kurrosetra/RCWS-FA/MotorControl/Boards/motorControl.brd

## EAGLE design MotorControl/Boards/motorControl.brd (2020-02-27)

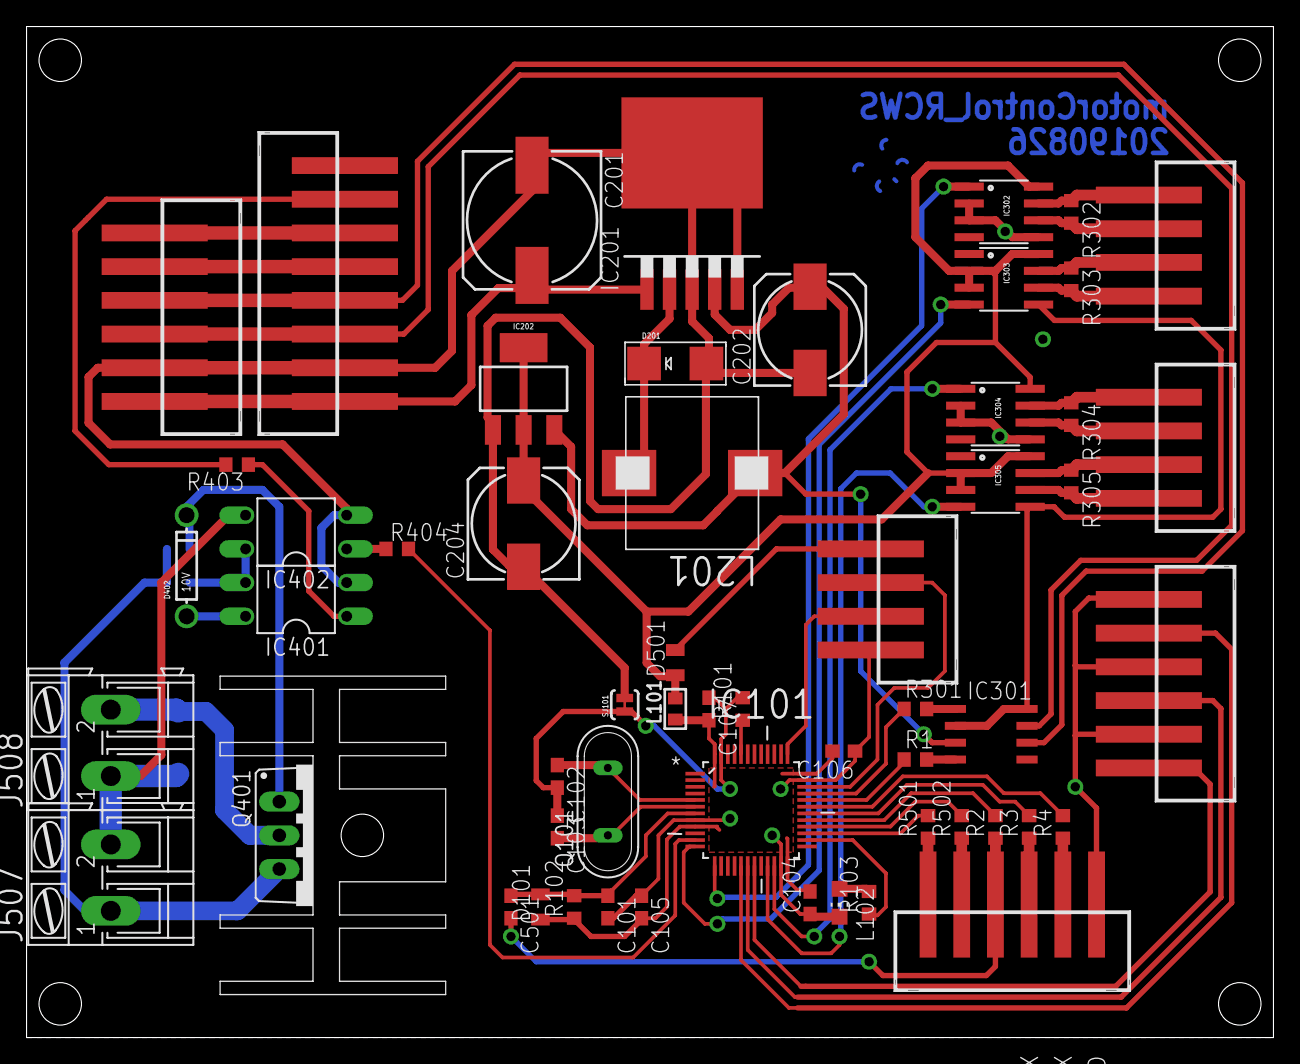
[picture p1: board motorControl.brd from above]

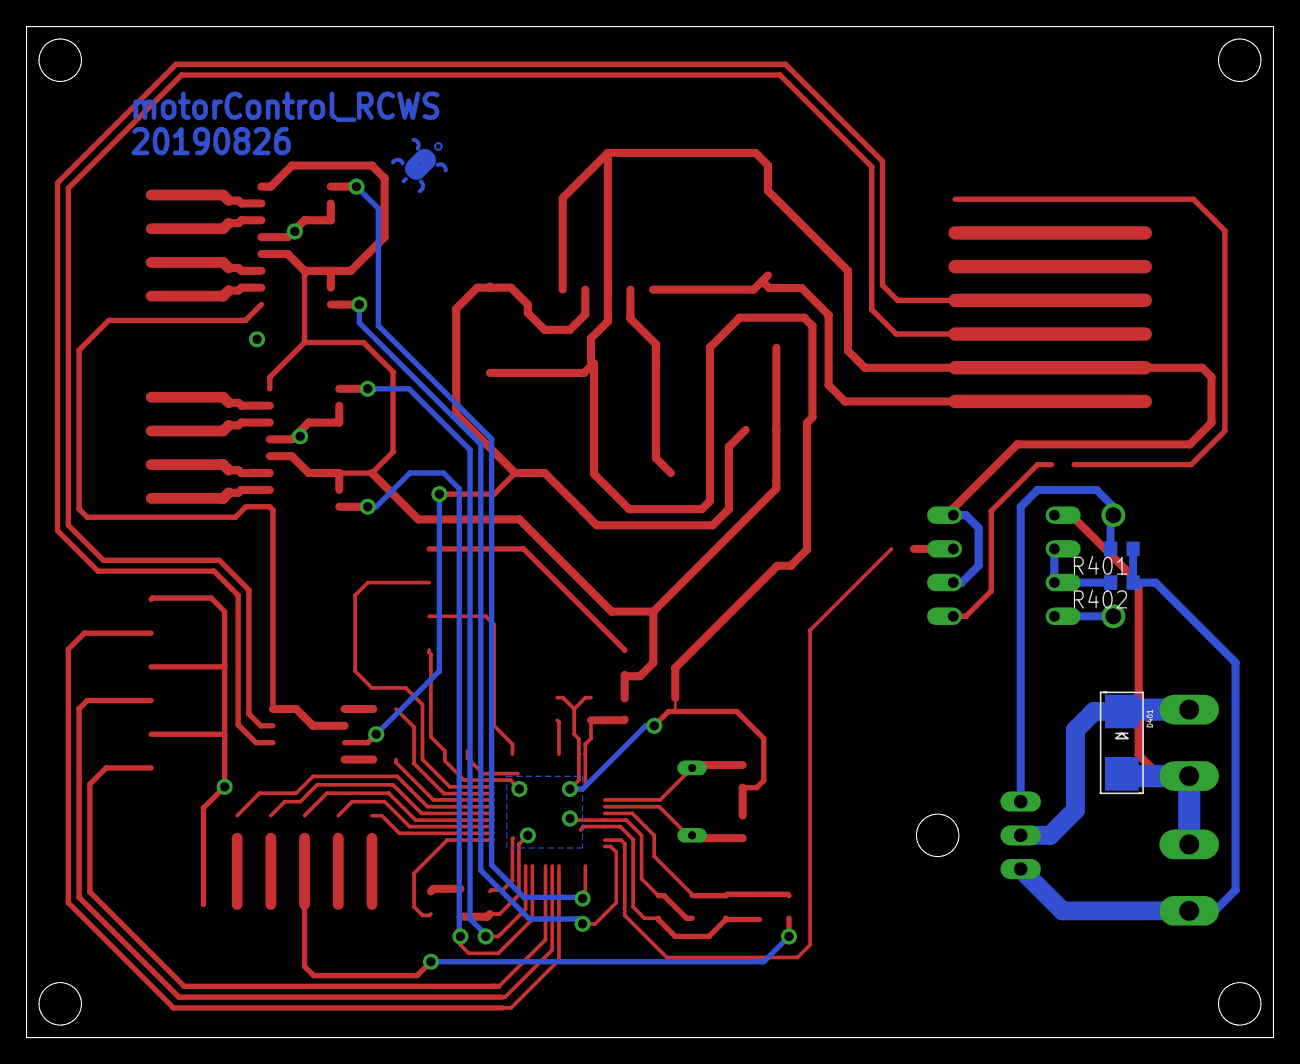
[picture p2: board motorControl.brd from below]

Board: 2 copper layers, 94.0 x 76.2 mm, 61 parts (3 on the bottom side), 59 nets.

Parts:
C101: 10n; C0603
C102, C103: 22p; C0603
C104, C105, C106, C107, C501: 100n; C0603
C201: 470u/35V; 153CLV-1012
C202, C204: 1000u/6V3; 153CLV-0810
D101, D501: SCHOTTKY; MICROMELF-W
D201, D401: SS34; SMADIODE
D402: 10V; DO-4148
IC101: STM32F103C8T6; QFP50P900X900X160-48N
IC201: LM2596S-5V; D2PAK
IC202: LM1117-3V3; SOT223
IC301: MCP2561-E/SN; SOIC-8
IC302, IC303, IC304, IC305: RS485SOIC; SO08
IC401, IC402: PC817; DIL04
J501: PROG; XH-4-VERT-SMD
J502: BUS; XH-8-VERT-SMD
J503: OPTRONIK; XH-6-VERT-SMD
J504: MTR_AZ_COMM; XH-4-VERT-SMD
J505: MTR_EL_COMM; XH-4-VERT-SMD
J506: LIMIT_SWITCH; XH-6-VERT-SMD
J507: POWER_IN; AK300/2
J508: TRIGGER_OUT; AK300/2
J509: COCK_DRIVER; XH-6-VERT-SMD
KK401: BV_240X170-HOLE
L101: FB_0603; L0603
L102: GREEN; CHIP-LED0805
L201: 33uH; PA4342
Q101: 8MHz; QS
Q401: IRF9530; TO220BV
R1, R2, R3, R4, R301, R302, R303, R304, R305, R501, R502: 120R; R0603
R101, R102: 100K; R0603
R103: 1k; R0603
R401: 470R; R0603
R402: 100k; R0603
R403, R404: 330R; R0603
SJ101: SJ_2S-TRACE
U$1: KURRO_FOOTPRINT; KURRO-LOGO

Connections:
+3V3: C204.+, D501.C, IC202.2, IC202.4, IC302.8, IC303.2, IC303.3, IC303.8, IC304.8, IC305.2, IC305.3, IC305.8, L101.2
+5V: C202.+, IC201.4, IC202.3, IC301.3, L201.P$2
+12V: C201.+, IC201.1, J502.1, J503.6
+24V: J507.1, Q401.S, R401.1, R402.1
AGND: C101.2, C102.2, C103.1, C104.1, C105.1, C106.1, C107.1, IC101.8, IC101.23, IC101.35, IC101.47, J501.4, L102.C, R101.2, SJ101.1
BOOT0: IC101.44, R101.1
BUS_CANH: IC301.7, J502.3, J503.4
BUS_CANL: IC301.6, J502.4, J503.3
BUS_RXD: IC101.32, R1.1
BUS_TRIGGER_PULSE: J502.7, R403.2
BUS_TXD: IC101.33, R301.1
BUS_VIDEO+: J502.5, J503.2
BUS_VIDEO-: J502.6, J503.1
COCK_ALM: IC101.31, R4.2
COCK_AWO: IC101.28, R502.2
COCK_DIR: IC101.29, R2.2
COCK_PLS: IC101.30, R3.2
COCK_POS: IC101.27, R501.2
GND: C201.-, C202.-, C204.-, D201.A, IC201.3, IC201.5, IC201.6, IC202.1, IC301.2, IC301.8, IC302.2, IC302.3, IC302.5, IC303.5, IC304.2, IC304.3, IC304.5, IC305.5, IC401.2, IC402.2, J502.2, J503.5, J506.1, J506.3, J506.5, J509.1, SJ101.2
LIM_AZ: IC101.17, J506.2
LIM_EL_DOWN: IC101.19, J506.6
LIM_EL_UP: IC101.18, J506.4
LM2596_OUT: D201.C, IC201.2, L201.P$1
MTR_AZ_RXD: IC101.13, IC302.1
MTR_AZ_RX_A: IC303.6, J504.4, R303.2
MTR_AZ_RX_B: IC303.7, J504.3, R303.1
MTR_AZ_TXD: IC101.12, IC303.4
MTR_AZ_TX_A: IC302.6, J504.2, R302.2
MTR_AZ_TX_B: IC302.7, J504.1, R302.1
MTR_EL_RXD: IC101.22, IC304.1
MTR_EL_RX_A: IC305.6, J505.4, R305.2
MTR_EL_RX_B: IC305.7, J505.3, R305.1
MTR_EL_TXD: IC101.21, IC305.4
MTR_EL_TX_A: IC304.6, J505.2, R304.2
MTR_EL_TX_B: IC304.7, J505.1, R304.1
unnamed: L102.A, R103.2
unnamed: IC101.26, R103.1
unnamed: C103.2, IC101.6, Q101.1
unnamed: C102.1, IC101.5, Q101.2
unnamed: IC301.1, R301.2
unnamed: IC301.4, R1.2
unnamed: J509.5, R502.1
unnamed: J509.6, R501.1
unnamed: C501.2, J509.4, R2.1
unnamed: J509.3, R3.1
unnamed: J509.2, R4.1
unnamed: D501.A, J501.1
unnamed: D402.C, Q401.G, R401.2
unnamed: IC401.3, IC402.4, R402.2
unnamed: IC401.1, R403.1
unnamed: IC402.1, R404.1
unnamed: D402.A, IC401.4
RST: C101.1, C501.1, D101.A, IC101.7, R102.2
SWCLK: IC101.37, J501.3
SWDIO: IC101.34, J501.2
TRIGGER+: D401.C, J508.2, Q401.D
TRIGGER_ENABLE: IC101.11, R404.2
V-: D401.A, IC402.3, J507.2, J508.1
VDD: C104.2, C105.2, C106.2, C107.2, D101.C, IC101.9, IC101.24, IC101.36, IC101.48, L101.1, R102.1
