kurrosetra/RCWS-FA/Button/Boards/Button.brd

## EAGLE design Button/Boards/Button.brd (2020-02-27)

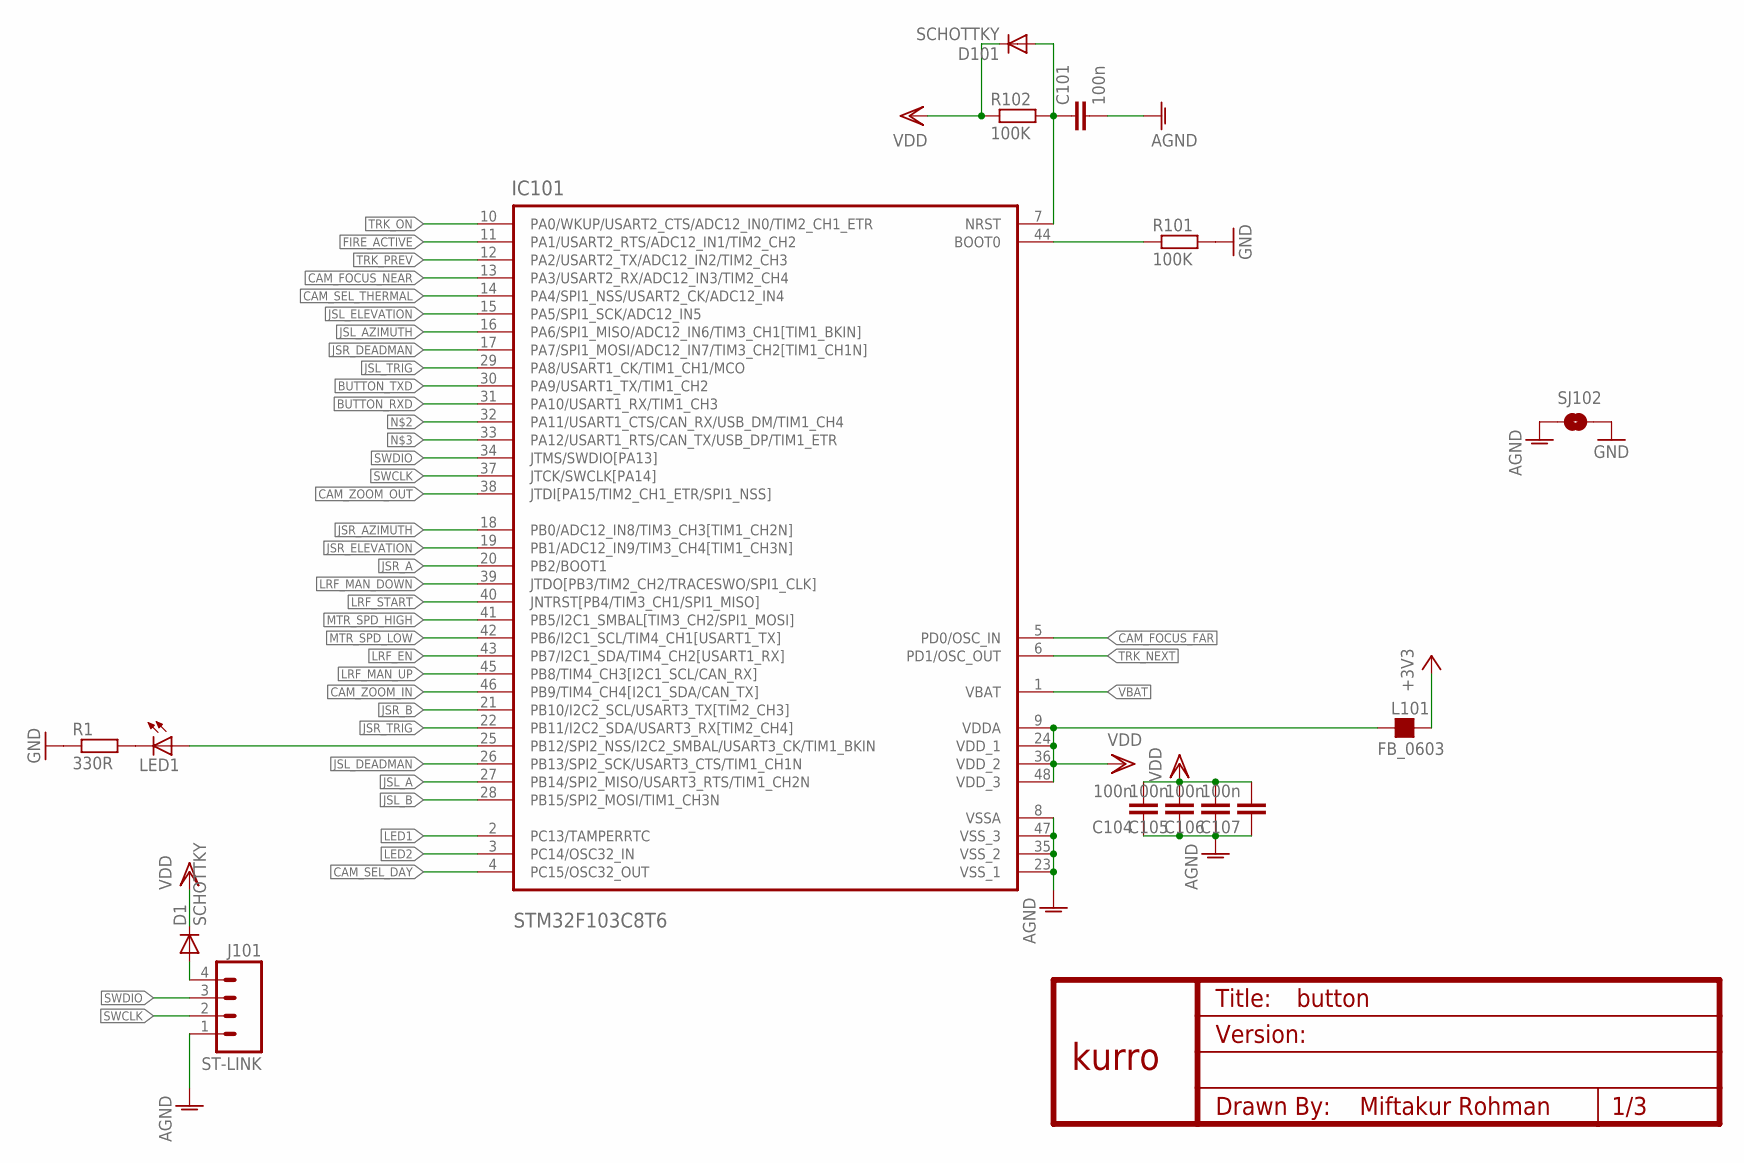
[picture p3: schematic Button.sch, sheet 1, CONTROLLER]

Parts:
C101, C104, C105, C106, C107: 100n; C0603
D1, D101: SCHOTTKY; MICROMELF-W
IC101: STM32F103C8T6; QFP50P900X900X160-48N
J101: ST-LINK; XH-4-VERT
L101: FB_0603; L0603
LED1: LED-3MM-NO_SILK; LED3MM-NS
R1: 330R; R0603
R101, R102: 100K; R0603
SJ102: SOLDERJUMPERTRACE; SJ_2S-TRACE
U$1: KURRO_FOOTPRINT; KURRO-LOGO

Connections:
+3V3: L101.2; also elsewhere on the board
AGND: C101.2, C104.1, C105.1, C106.1, C107.1, IC101.8 (VSSA), IC101.23 (VSS_1), IC101.35 (VSS_2), IC101.47 (VSS_3), J101.1, SJ102.1
BOOT0: IC101.44 (BOOT0), R101.1
BUTTON_RXD: IC101.31 (PA10/USART1_RX/TIM1_CH3); also elsewhere on the board
BUTTON_TXD: IC101.30 (PA9/USART1_TX/TIM1_CH2); also elsewhere on the board
CAM_FOCUS_FAR: IC101.5 (PD0/OSC_IN); also elsewhere on the board
CAM_FOCUS_NEAR: IC101.13 (PA3/USART2_RX/ADC12_IN3/TIM2_CH4); also elsewhere on the board
CAM_SEL_DAY: IC101.4 (PC15/OSC32_OUT); also elsewhere on the board
CAM_SEL_THERMAL: IC101.14 (PA4/SPI1_NSS/USART2_CK/ADC12_IN4); also elsewhere on the board
CAM_ZOOM_IN: IC101.46 (PB9/TIM4_CH4[I2C1_SDA/CAN_TX]); also elsewhere on the board
CAM_ZOOM_OUT: IC101.38 (JTDI[PA15/TIM2_CH1_ETR/SPI1_NSS]); also elsewhere on the board
FIRE_ACTIVE: IC101.11 (PA1/USART2_RTS/ADC12_IN1/TIM2_CH2); also elsewhere on the board
GND: R1.1, R101.2, SJ102.2; also elsewhere on the board
JSL_A: IC101.27 (PB14/SPI2_MISO/USART3_RTS/TIM1_CH2N); also elsewhere on the board
JSL_AZIMUTH: IC101.16 (PA6/SPI1_MISO/ADC12_IN6/TIM3_CH1[TIM1_B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); also elsewhere on the board
JSL_B: IC101.28 (PB15/SPI2_MOSI/TIM1_CH3N); also elsewhere on the board
JSL_DEADMAN: IC101.26 (PB13/SPI2_SCK/USART3_CTS/TIM1_CH1N); also elsewhere on the board
JSL_ELEVATION: IC101.15 (PA5/SPI1_SCK/ADC12_IN5); also elsewhere on the board
JSL_TRIG: IC101.29 (PA8/USART1_CK/TIM1_CH1/MCO); also elsewhere on the board
JSR_A: IC101.20 (PB2/BOOT1); also elsewhere on the board
JSR_AZIMUTH: IC101.18 (PB0/ADC12_IN8/TIM3_CH3[TIM1_CH2N]); also elsewhere on the board
JSR_B: IC101.21 (PB10/I2C2_SCL/USART3_TX[TIM2_CH3]); also elsewhere on the board
JSR_DEADMAN: IC101.17 (PA7/SPI1_MOSI/ADC12_IN7/TIM3_CH2[TIM1_C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); also elsewhere on the board
JSR_ELEVATION: IC101.19 (PB1/ADC12_IN9/TIM3_CH4[TIM1_CH3N]); also elsewhere on the board
JSR_TRIG: IC101.22 (PB11/I2C2_SDA/USART3_RX[TIM2_CH4]); also elsewhere on the board
LED1: IC101.2 (PC13/TAMPERRTC); also elsewhere on the board
LED2: IC101.3 (PC14/OSC32_IN); also elsewhere on the board
LRF_EN: IC101.43 (PB7/I2C1_SDA/TIM4_CH2[USART1_RX]); also elsewhere on the board
LRF_MAN_DOWN: IC101.39 (JTDO[PB3/TIM2_CH2/TRACESWO/SPI1_CLK]); also elsewhere on the board
LRF_MAN_UP: IC101.45 (PB8/TIM4_CH3[I2C1_SCL/CAN_RX]); also elsewhere on the board
LRF_START: IC101.40 (JNTRST[PB4/TIM3_CH1/SPI1_MISO]); also elsewhere on the board
MTR_SPD_HIGH: IC101.41 (PB5/I2C1_SMBAL[TIM3_CH2/SPI1_MOSI]); also elsewhere on the board
MTR_SPD_LOW: IC101.42 (PB6/I2C1_SCL/TIM4_CH1[USART1_TX]); also elsewhere on the board
unnamed: IC101.25 (PB12/SPI2_NSS/I2C2_SMBAL/USART3_CK/TIM1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), LED1.A
unnamed: D1.A, J101.4
unnamed: LED1.K (C), R1.2
RST: C101.1, D101.A, IC101.7 (NRST), R102.2
SWCLK: IC101.37 (JTCK/SWCLK[PA14]), J101.2
SWDIO: IC101.34 (JTMS/SWDIO[PA13]), J101.3
TRK_NEXT: IC101.6 (PD1/OSC_OUT); also elsewhere on the board
TRK_ON: IC101.10 (PA0/WKUP/USART2_CTS/ADC12_IN0/TIM2_CH1_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); also elsewhere on the board
TRK_PREV: IC101.12 (PA2/USART2_TX/ADC12_IN2/TIM2_CH3); also elsewhere on the board
VBAT: IC101.1 (VBAT)
VDD: C104.2, C105.2, C106.2, C107.2, D1.C, D101.C, IC101.9 (VDDA), IC101.24 (VDD_1), IC101.36 (VDD_2), IC101.48 (VDD_3), L101.1, R102.1

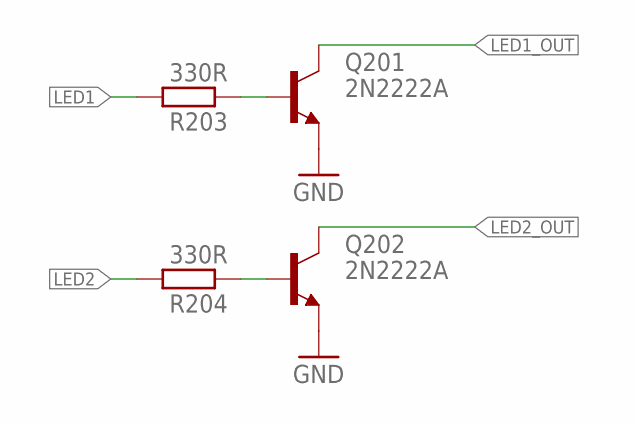
[picture p4: schematic Button.sch, sheet 2]

Parts:
Q201, Q202: 2N2222A; SOT23
R203, R204: 330R; R0603

Connections:
GND: Q201.2 (E), Q202.2 (E); also elsewhere on the board
LED1: R203.2; also elsewhere on the board
LED1_OUT: Q201.3 (C); also elsewhere on the board
LED2: R204.2; also elsewhere on the board
LED2_OUT: Q202.3 (C); also elsewhere on the board
unnamed: Q201.1 (B), R203.1
unnamed: Q202.1 (B), R204.1

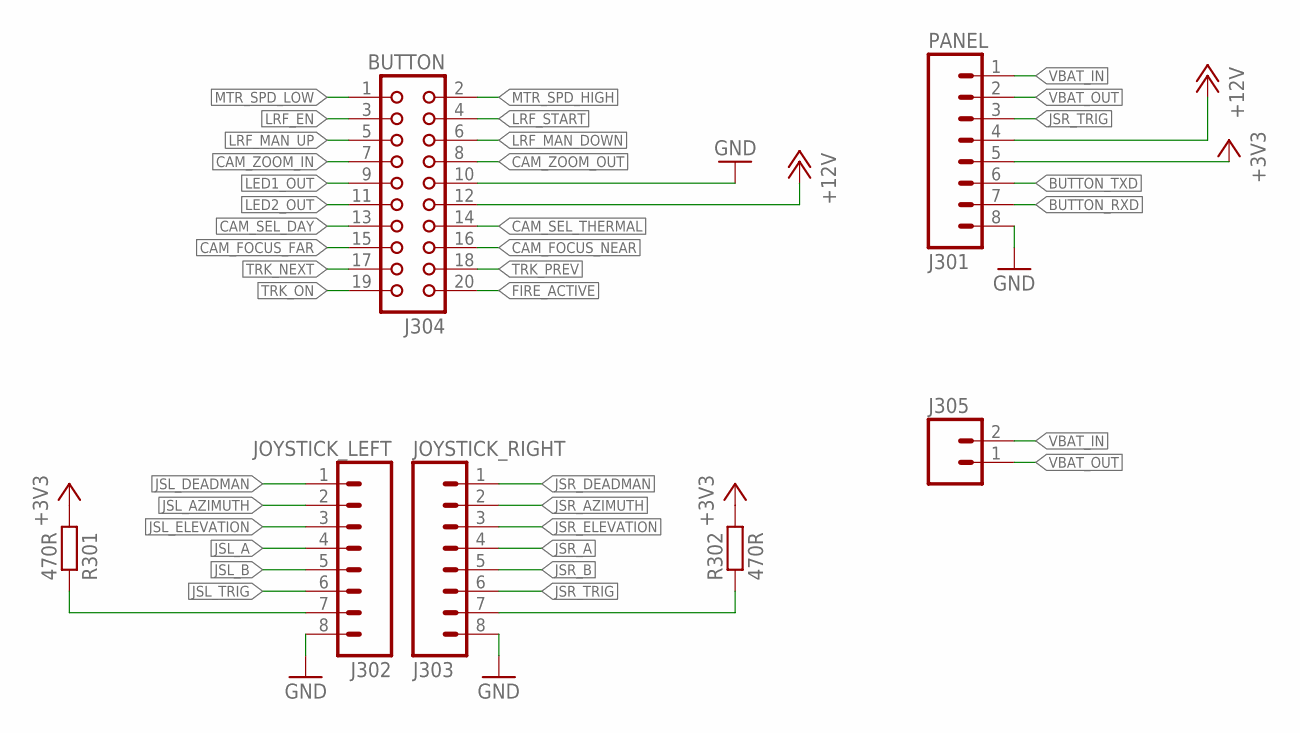
[picture p5: schematic Button.sch, sheet 3, CONNECTOR]

Parts:
J301: PANEL; XH-8-RA
J302: JOYSTICK_LEFT; XH-8-RA
J303: JOYSTICK_RIGHT; XH-8-RA
J304: BUTTON; CON20
J305: M02-XH-RA; XH-2-RA
R301, R302: 470R; R0603

Connections:
+3V3: J301.5, R301.2, R302.2; also elsewhere on the board
+12V: J301.4, J304.12
BUTTON_RXD: J301.7; also elsewhere on the board
BUTTON_TXD: J301.6; also elsewhere on the board
CAM_FOCUS_FAR: J304.15; also elsewhere on the board
CAM_FOCUS_NEAR: J304.16; also elsewhere on the board
CAM_SEL_DAY: J304.13; also elsewhere on the board
CAM_SEL_THERMAL: J304.14; also elsewhere on the board
CAM_ZOOM_IN: J304.7; also elsewhere on the board
CAM_ZOOM_OUT: J304.8; also elsewhere on the board
FIRE_ACTIVE: J304.20; also elsewhere on the board
GND: J301.8, J302.8, J303.8, J304.10; also elsewhere on the board
JSL_A: J302.4; also elsewhere on the board
JSL_AZIMUTH: J302.2; also elsewhere on the board
JSL_B: J302.5; also elsewhere on the board
JSL_DEADMAN: J302.1; also elsewhere on the board
JSL_ELEVATION: J302.3; also elsewhere on the board
JSL_TRIG: J302.6; also elsewhere on the board
JSR_A: J303.4; also elsewhere on the board
JSR_AZIMUTH: J303.2; also elsewhere on the board
JSR_B: J303.5; also elsewhere on the board
JSR_DEADMAN: J303.1; also elsewhere on the board
JSR_ELEVATION: J303.3; also elsewhere on the board
JSR_TRIG: J301.3, J303.6; also elsewhere on the board
LED1_OUT: J304.9; also elsewhere on the board
LED2_OUT: J304.11; also elsewhere on the board
LRF_EN: J304.3; also elsewhere on the board
LRF_MAN_DOWN: J304.6; also elsewhere on the board
LRF_MAN_UP: J304.5; also elsewhere on the board
LRF_START: J304.4; also elsewhere on the board
MTR_SPD_HIGH: J304.2; also elsewhere on the board
MTR_SPD_LOW: J304.1; also elsewhere on the board
unnamed: J303.7, R302.1
unnamed: J302.7, R301.1
TRK_NEXT: J304.17; also elsewhere on the board
TRK_ON: J304.19; also elsewhere on the board
TRK_PREV: J304.18; also elsewhere on the board
VBAT_IN: J301.1, J305.2
VBAT_OUT: J301.2, J305.1

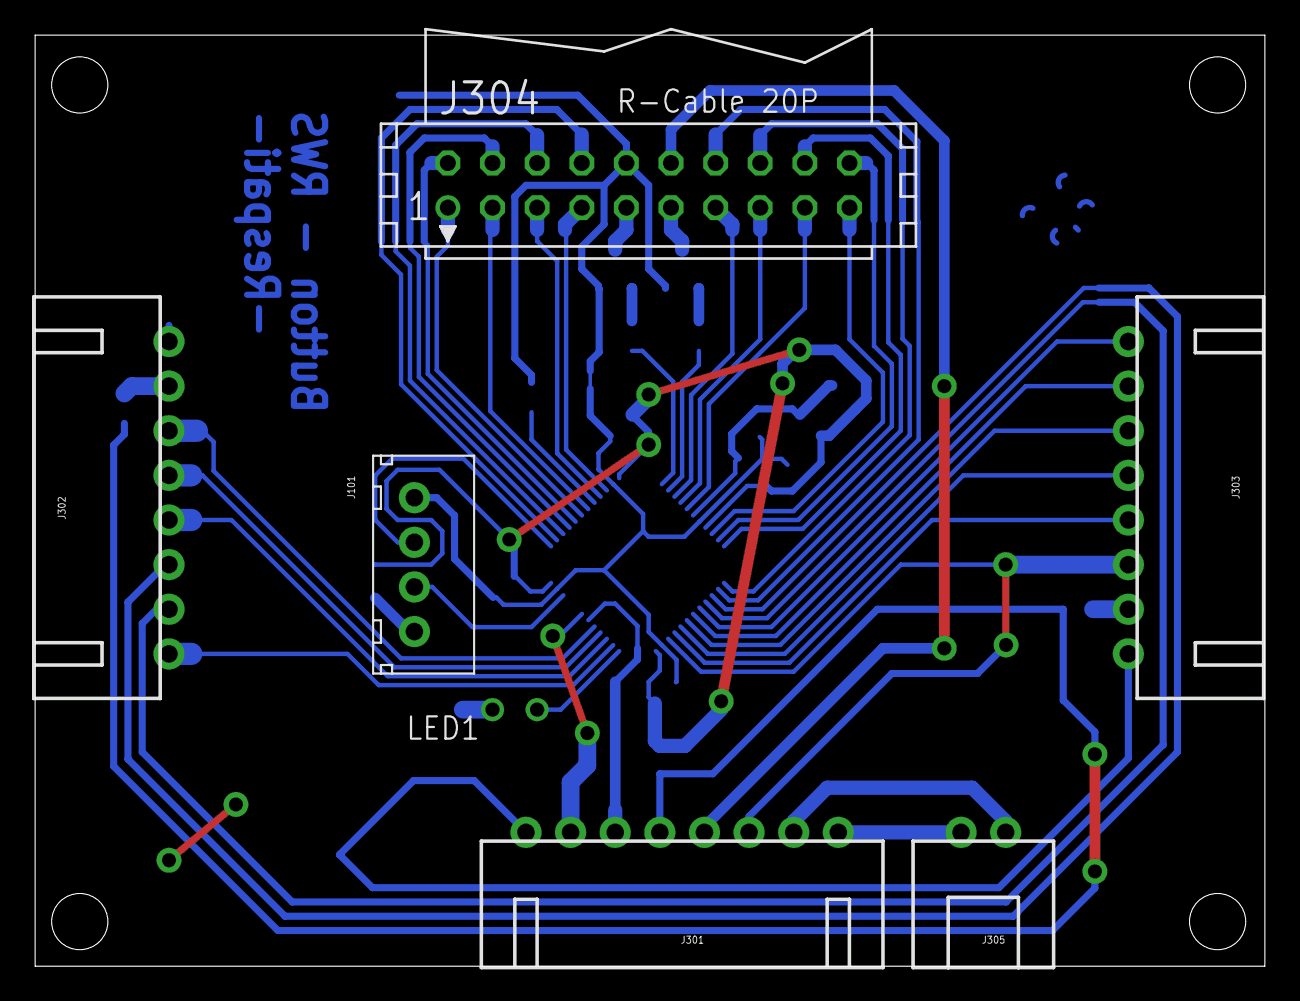
[picture p6: board Button.brd from above]

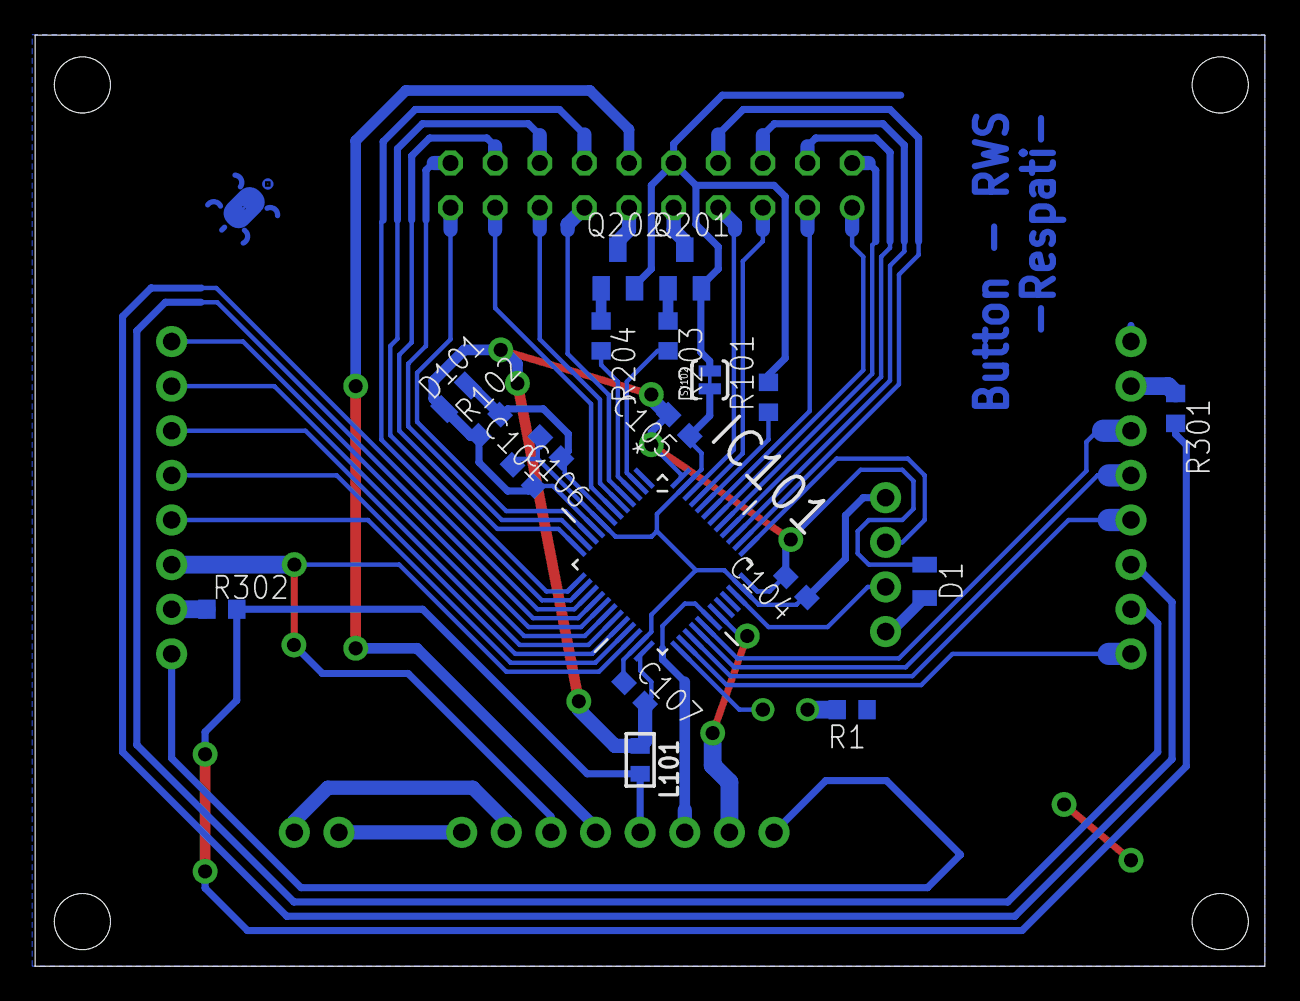
[picture p7: board Button.brd from below]

Board: 2 copper layers, 70.0 x 53.0 mm, 27 parts (19 on the bottom side), 52 nets.
