kurrosetra/RCWS-FA/Panel/Boards/panel446.brd

## EAGLE design Panel/Boards/panel446.brd (2020-02-27)

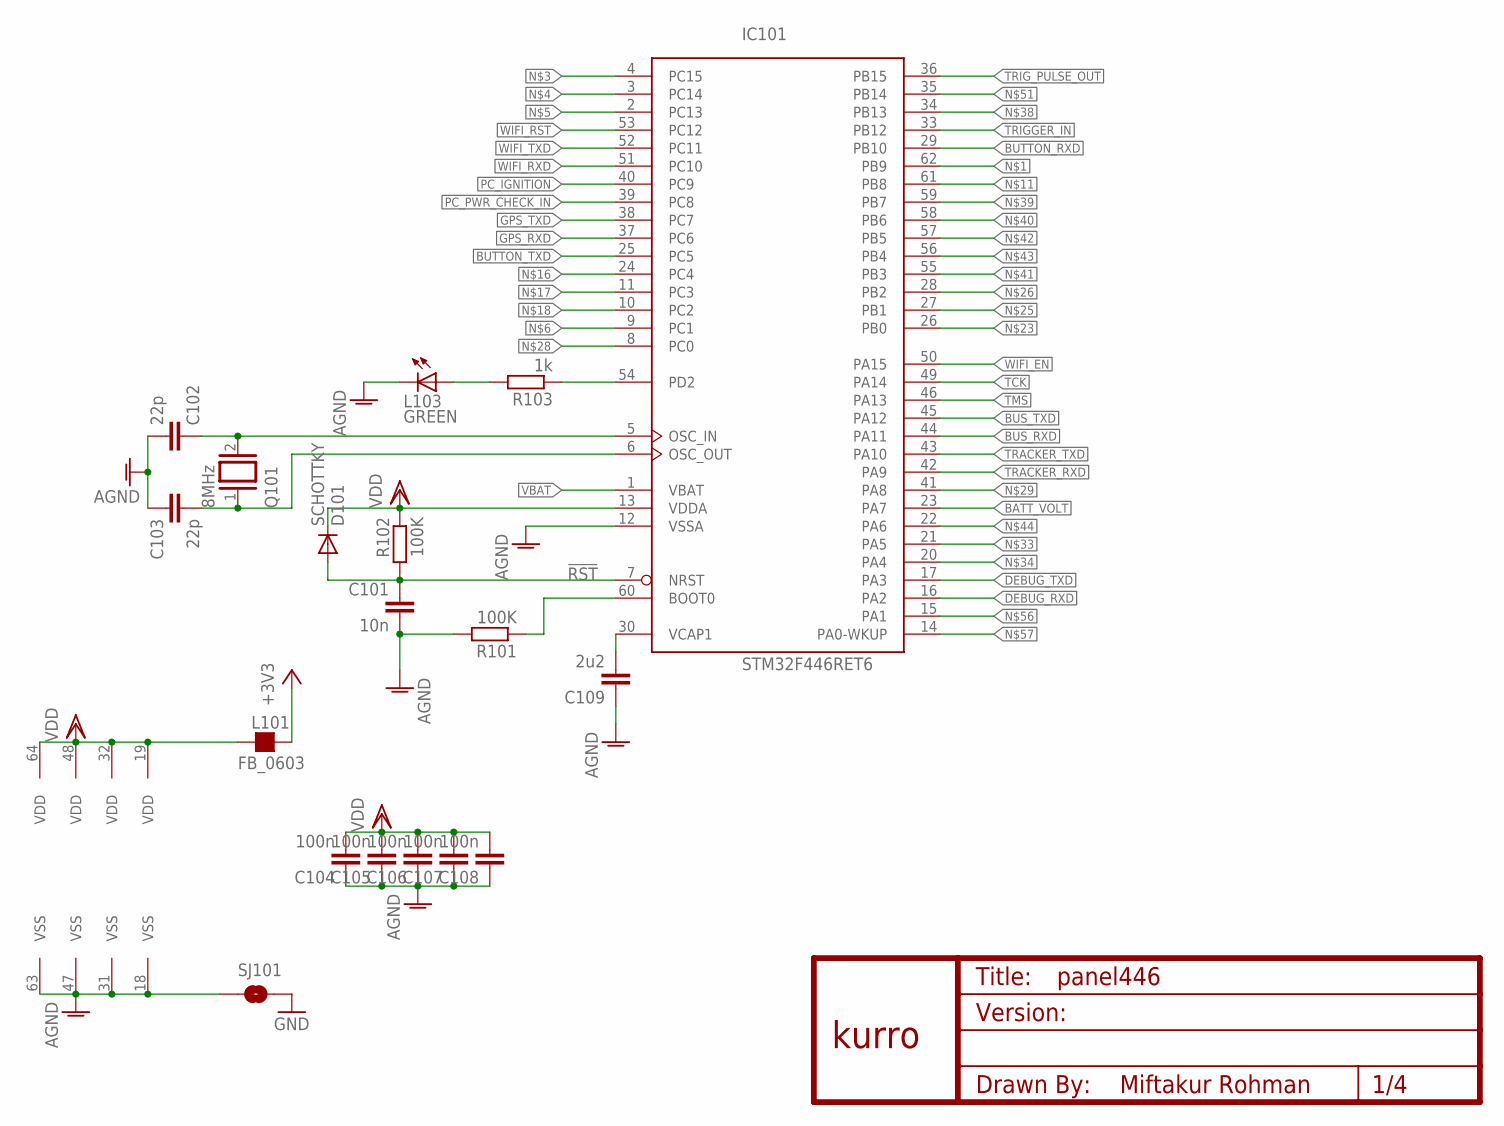
[picture p8: schematic panel446.sch, sheet 1, MAIN]

Parts:
C101: 10n; C0603
C102, C103: 22p; C0603
C104, C105, C106, C107, C108: 100n; C0603
C109: 2u2; C0805
D101: SCHOTTKY; MICROMELF-W
IC101: STM32F446RET6; LQFP64
L101: FB_0603; L0603
L103: GREEN; CHIP-LED0805
Q101: 8MHz; QS
R101, R102: 100K; R0603
R103: 1k; R0603
SJ101: SOLDERJUMPERTRACE; SJ_2S-TRACE
U$1: KURRO_FOOTPRINT; KURRO-LOGO

Connections:
!RST: C101.1, D101.A, IC101.7 (NRST), R102.2; also elsewhere on the board
+3V3: L101.2; also elsewhere on the board
AGND: C101.2, C102.2, C103.1, C104.1, C105.1, C106.1, C107.1, C108.1, C109.1, IC101.12 (VSSA), IC101.18 (VSS), IC101.31 (VSS), IC101.47 (VSS), IC101.63 (VSS), L103.C, R101.2, SJ101.1; also elsewhere on the board
BATT_VOLT: IC101.23 (PA7); also elsewhere on the board
BOOT1: IC101.60 (BOOT0), R101.1
BUS_RXD: IC101.44 (PA11); also elsewhere on the board
BUS_TXD: IC101.45 (PA12); also elsewhere on the board
BUTTON_RXD: IC101.29 (PB10); also elsewhere on the board
BUTTON_TXD: IC101.25 (PC5); also elsewhere on the board
DEBUG_RXD: IC101.16 (PA2); also elsewhere on the board
DEBUG_TXD: IC101.17 (PA3); also elsewhere on the board
GND: SJ101.2; also elsewhere on the board
GPS_RXD: IC101.37 (PC6); also elsewhere on the board
GPS_TXD: IC101.38 (PC7); also elsewhere on the board
unnamed: C109.2, IC101.30 (VCAP1)
unnamed: IC101.54 (PD2), R103.1
unnamed: L103.A, R103.2
unnamed: C103.2, IC101.6 (OSC_OUT), Q101.1
unnamed: C102.1, IC101.5 (OSC_IN), Q101.2
PC_IGNITION: IC101.40 (PC9); also elsewhere on the board
PC_PWR_CHECK_IN: IC101.39 (PC8); also elsewhere on the board
TCK: IC101.49 (PA14); also elsewhere on the board
TMS: IC101.46 (PA13); also elsewhere on the board
TRACKER_RXD: IC101.42 (PA9); also elsewhere on the board
TRACKER_TXD: IC101.43 (PA10); also elsewhere on the board
TRIGGER_IN: IC101.33 (PB12); also elsewhere on the board
TRIG_PULSE_OUT: IC101.36 (PB15); also elsewhere on the board
VBAT: IC101.1 (VBAT)
VDD: C104.2, C105.2, C106.2, C107.2, C108.2, D101.C, IC101.13 (VDDA), IC101.19 (VDD), IC101.32 (VDD), IC101.48 (VDD), IC101.64 (VDD), L101.1, R102.1; also elsewhere on the board
WIFI_EN: IC101.50 (PA15); also elsewhere on the board
WIFI_RST: IC101.53 (PC12); also elsewhere on the board
WIFI_RXD: IC101.51 (PC10); also elsewhere on the board
WIFI_TXD: IC101.52 (PC11); also elsewhere on the board

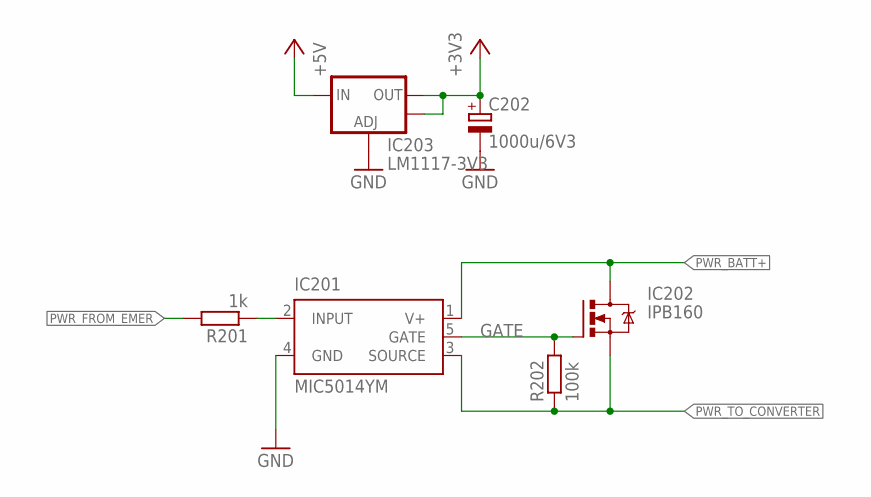
[picture p9: schematic panel446.sch, sheet 2]

Parts:
C202: 1000u/6V3; 153CLV-0810
IC201: MIC5014YM; SO-08
IC202: IPB160; PG-TO263-7
IC203: LM1117-3V3; SOT223
R201: 1k; R0603
R202: 100k; R0603

Connections:
+3V3: C202.+, IC203.2 (OUT), IC203.4 (OUT); also elsewhere on the board
+5V: IC203.3 (IN); also elsewhere on the board
GATE: IC201.5 (GATE), IC202.1 (G), R202.2
GND: C202.-, IC201.4 (GND), IC203.1 (ADJ); also elsewhere on the board
unnamed: IC201.2 (INPUT), R201.1
PWR_BATT+: IC201.1 (V+), IC202.4 (D); also elsewhere on the board
PWR_FROM_EMER: R201.2; also elsewhere on the board
PWR_TO_CONVERTER: IC201.3 (SOURCE), IC202.2 (S), IC202.3 (S), IC202.5 (S), IC202.6 (S), IC202.7 (S), R202.1; also elsewhere on the board

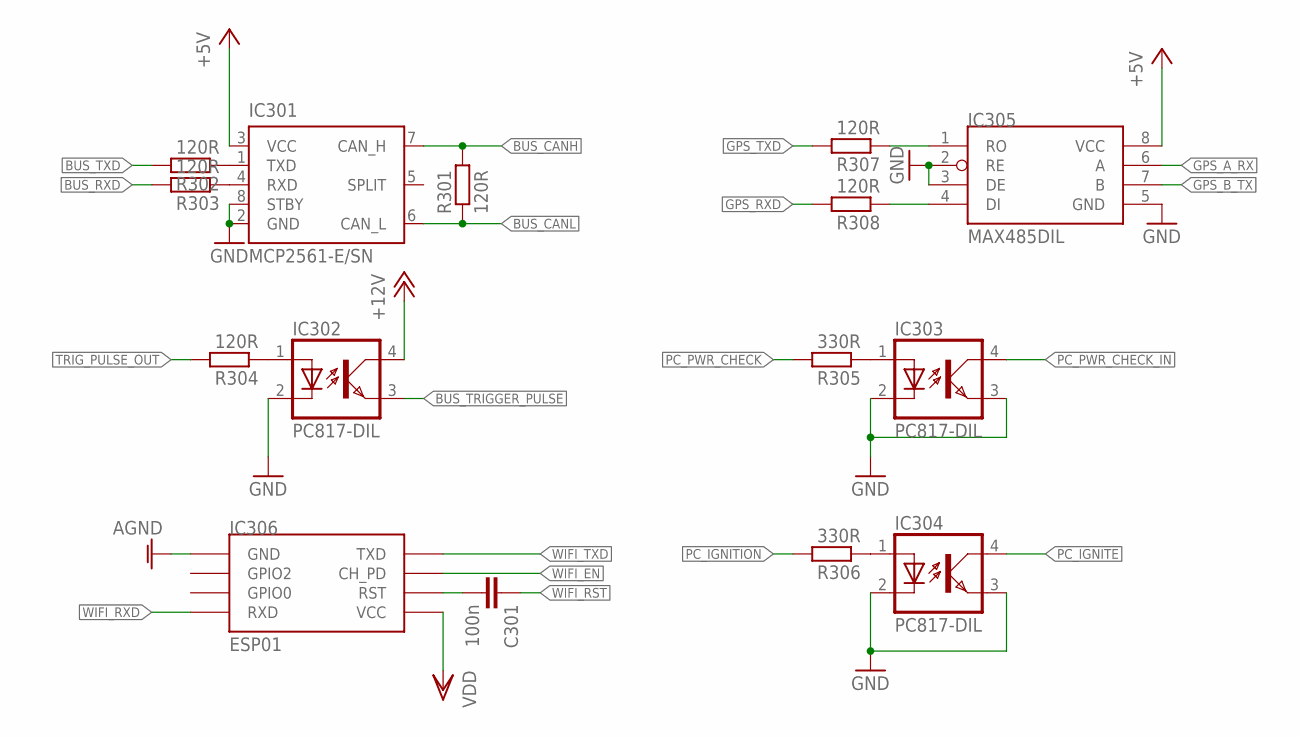
[picture p10: schematic panel446.sch, sheet 3]

Parts:
C301: 100n; C0603
IC301: MCP2561-E/SN; SOIC-8
IC302, IC303, IC304: PC817-DIL; DIL04A
IC305: MAX485DIL; DIL08
IC306: ESP01
R301, R302, R303, R304, R307, R308: 120R; R0603
R305, R306: 330R; R0603

Connections:
+5V: IC301.3 (VCC), IC305.8 (VCC); also elsewhere on the board
+12V: IC302.4 (COL); also elsewhere on the board
AGND: IC306.GND; also elsewhere on the board
BUS_CANH: IC301.7 (CAN_H), R301.2; also elsewhere on the board
BUS_CANL: IC301.6 (CAN_L), R301.1; also elsewhere on the board
BUS_RXD: R303.2; also elsewhere on the board
BUS_TRIGGER_PULSE: IC302.3 (EMIT); also elsewhere on the board
BUS_TXD: R302.2; also elsewhere on the board
GND: IC301.2 (GND), IC301.8 (STBY), IC302.2 (C), IC303.2 (C), IC303.3 (EMIT), IC304.2 (C), IC304.3 (EMIT), IC305.2 (RE), IC305.3 (DE), IC305.5 (GND); also elsewhere on the board
GPS_A_RX: IC305.6 (A); also elsewhere on the board
GPS_B_TX: IC305.7 (B); also elsewhere on the board
GPS_RXD: R308.2; also elsewhere on the board
GPS_TXD: R307.2; also elsewhere on the board
unnamed: C301.2, IC306.RST
unnamed: IC301.4 (RXD), R303.1
unnamed: IC301.1 (TXD), R302.1
unnamed: IC302.1 (A), R304.1
unnamed: IC303.1 (A), R305.1
unnamed: IC305.1 (RO), R307.1
unnamed: IC305.4 (DI), R308.1
unnamed: IC304.1 (A), R306.1
PC_IGNITE: IC304.4 (COL); also elsewhere on the board
PC_IGNITION: R306.2; also elsewhere on the board
PC_PWR_CHECK: R305.2; also elsewhere on the board
PC_PWR_CHECK_IN: IC303.4 (COL); also elsewhere on the board
TRIG_PULSE_OUT: R304.2; also elsewhere on the board
VDD: IC306.VCC; also elsewhere on the board
WIFI_EN: IC306.CH_PD; also elsewhere on the board
WIFI_RST: C301.1; also elsewhere on the board
WIFI_RXD: IC306.RX (RXD); also elsewhere on the board
WIFI_TXD: IC306.TX (TXD); also elsewhere on the board

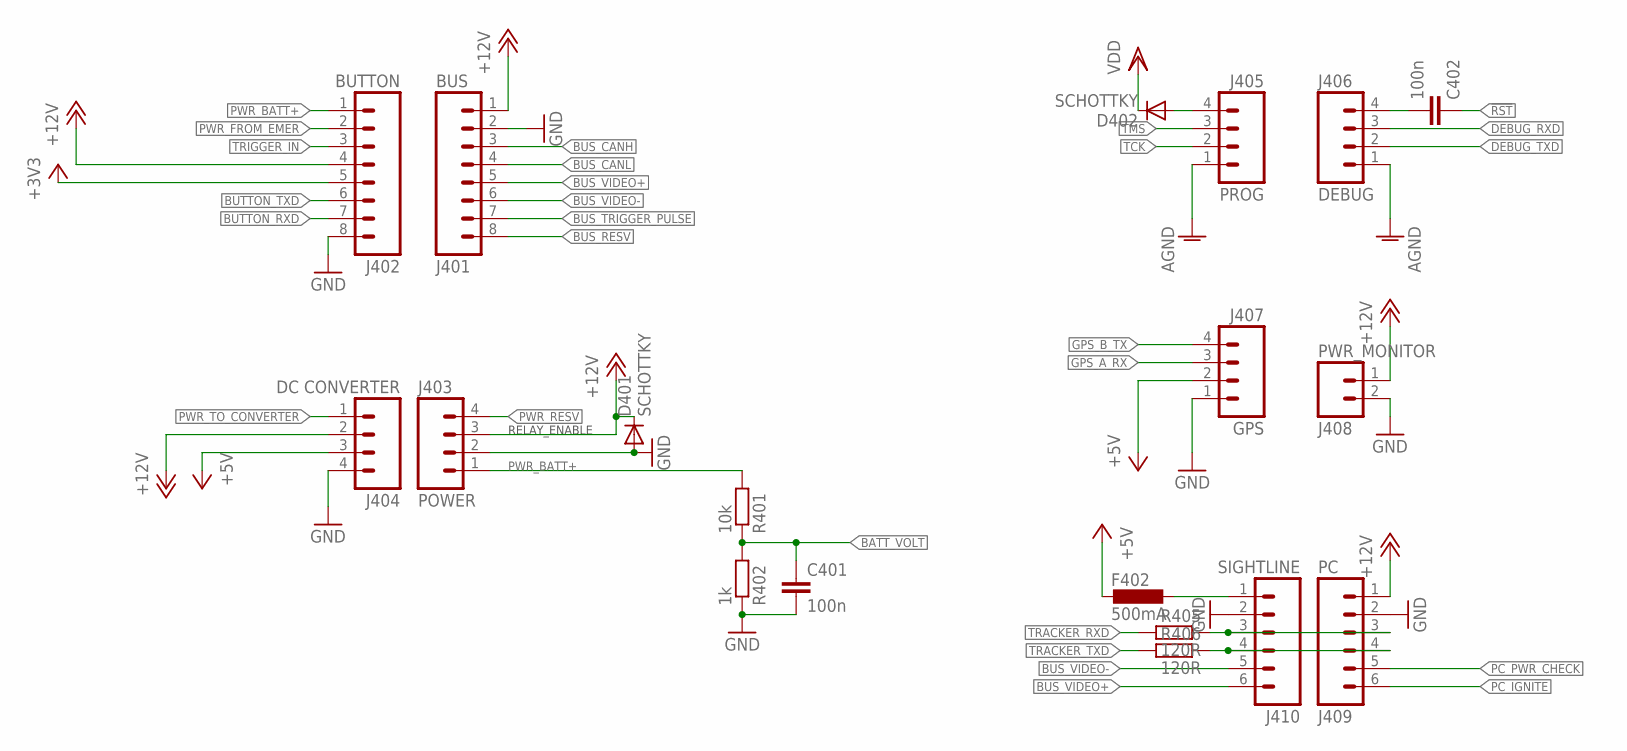
[picture p11: schematic panel446.sch, sheet 4, CONNECTOR]

Parts:
C401, C402: 100n; C0603
D401, D402: SCHOTTKY; MICROMELF-W
F402: 500mA; L0805
J401: BUS; XH-8-VERT
J402: BUTTON; XH-8-VERT
J403: POWER; XH-4-VERT
J404: DC CONVERTER; XH-4-VERT
J405: PROG; XH-4-VERT
J406: DEBUG; XH-4-VERT
J407: GPS; XH-4-VERT
J408: PWR_MONITOR; XH-2-RA
J409: PC; XH-6-VERT
J410: SIGHTLINE; XH-6-VERT
R401: 10k; R0603
R402: 1k; R0603
R405, R406: 120R; R0603

Connections:
!RST: C402.1; also elsewhere on the board
+3V3: J402.5; also elsewhere on the board
+5V: F402.2, J404.3, J407.2; also elsewhere on the board
+12V: D401.C, J401.1, J402.4, J403.3, J404.2, J408.1, J409.1; also elsewhere on the board
AGND: J405.1, J406.1; also elsewhere on the board
BATT_VOLT: C401.1, R401.1, R402.2; also elsewhere on the board
BUS_CANH: J401.3; also elsewhere on the board
BUS_CANL: J401.4; also elsewhere on the board
BUS_RESV: J401.8
BUS_TRIGGER_PULSE: J401.7; also elsewhere on the board
BUS_VIDEO+: J401.5, J410.6
BUS_VIDEO-: J401.6, J410.5
BUTTON_RXD: J402.7; also elsewhere on the board
BUTTON_TXD: J402.6; also elsewhere on the board
DEBUG_RXD: J406.3; also elsewhere on the board
DEBUG_TXD: J406.2; also elsewhere on the board
GND: C401.2, D401.A, J401.2, J402.8, J403.2, J404.4, J407.1, J408.2, J409.2, J410.2, R402.1; also elsewhere on the board
GPS_A_RX: J407.3; also elsewhere on the board
GPS_B_TX: J407.4; also elsewhere on the board
unnamed: J409.3, J410.3, R405.1
unnamed: J409.4, J410.4, R406.1
unnamed: D402.A, J405.4
unnamed: C402.2, J406.4
unnamed: F402.1, J410.1
PC_IGNITE: J409.6; also elsewhere on the board
PC_PWR_CHECK: J409.5; also elsewhere on the board
PWR_BATT+: J402.1, J403.1, R401.2; also elsewhere on the board
PWR_FROM_EMER: J402.2; also elsewhere on the board
PWR_RESV: J403.4
PWR_TO_CONVERTER: J404.1; also elsewhere on the board
TCK: J405.2; also elsewhere on the board
TMS: J405.3; also elsewhere on the board
TRACKER_RXD: R405.2; also elsewhere on the board
TRACKER_TXD: R406.2; also elsewhere on the board
TRIGGER_IN: J402.3; also elsewhere on the board
VDD: D402.C; also elsewhere on the board

Notes on the sheet:
RELAY_ENABLE
