kurrosetra/RCWS-FA/Panel/Boards/panel446.brd

## EAGLE design Panel/Boards/panel446.brd (continued)

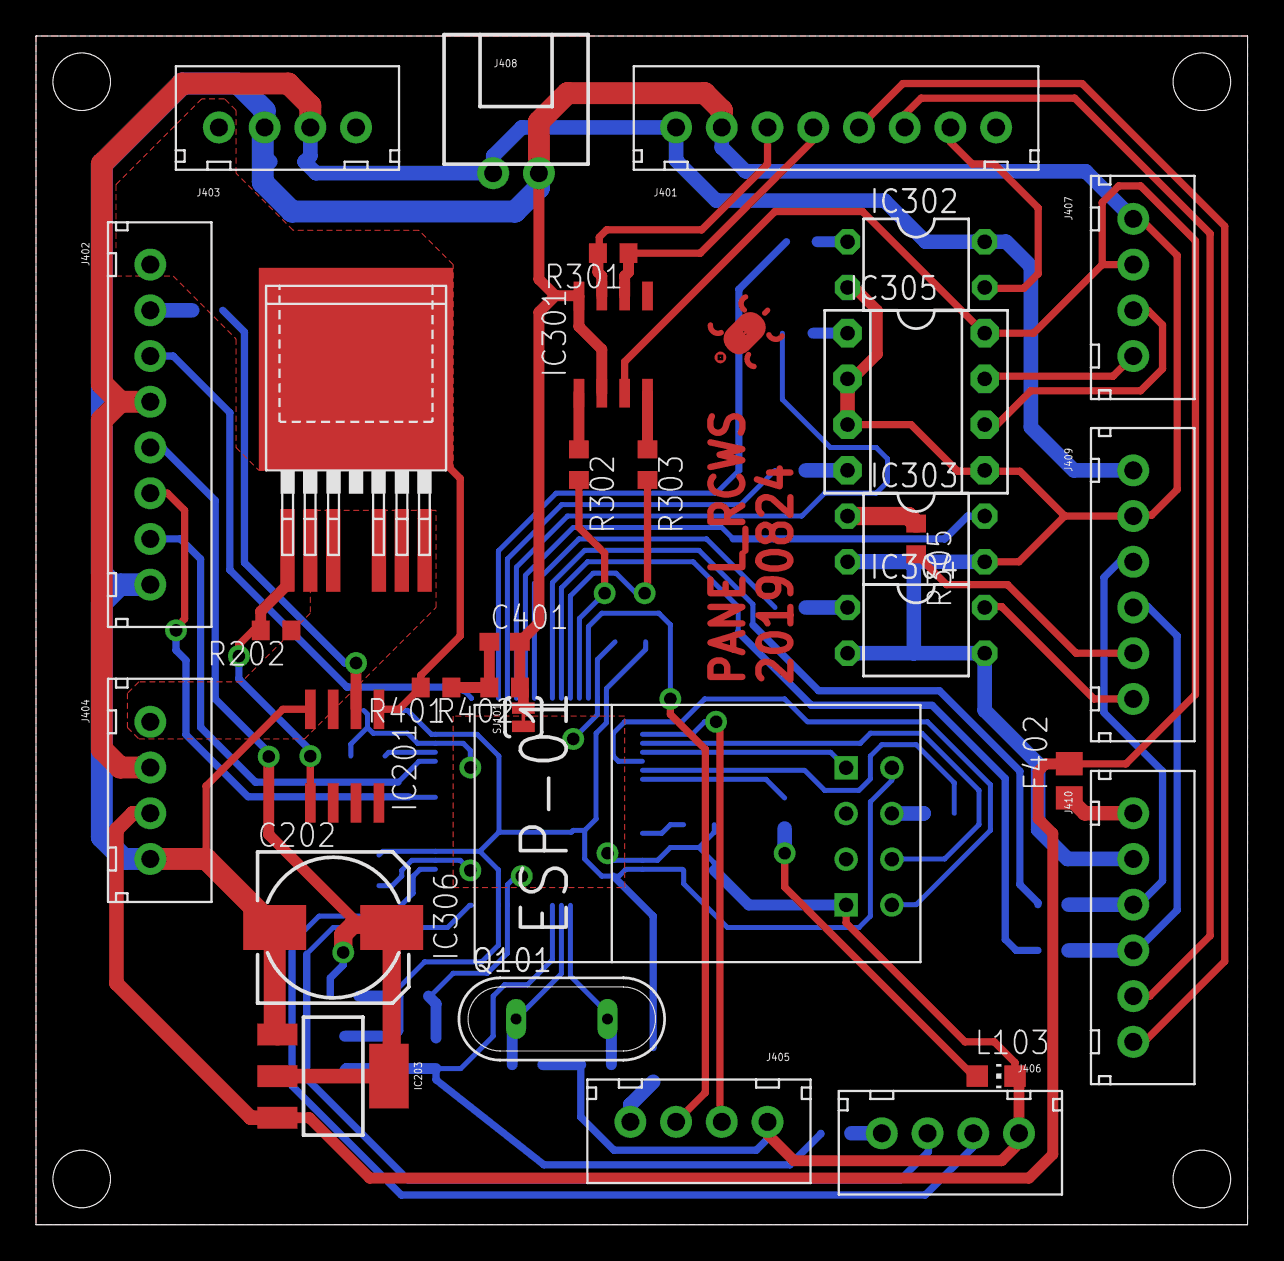
[picture p12: board panel446.brd from above]

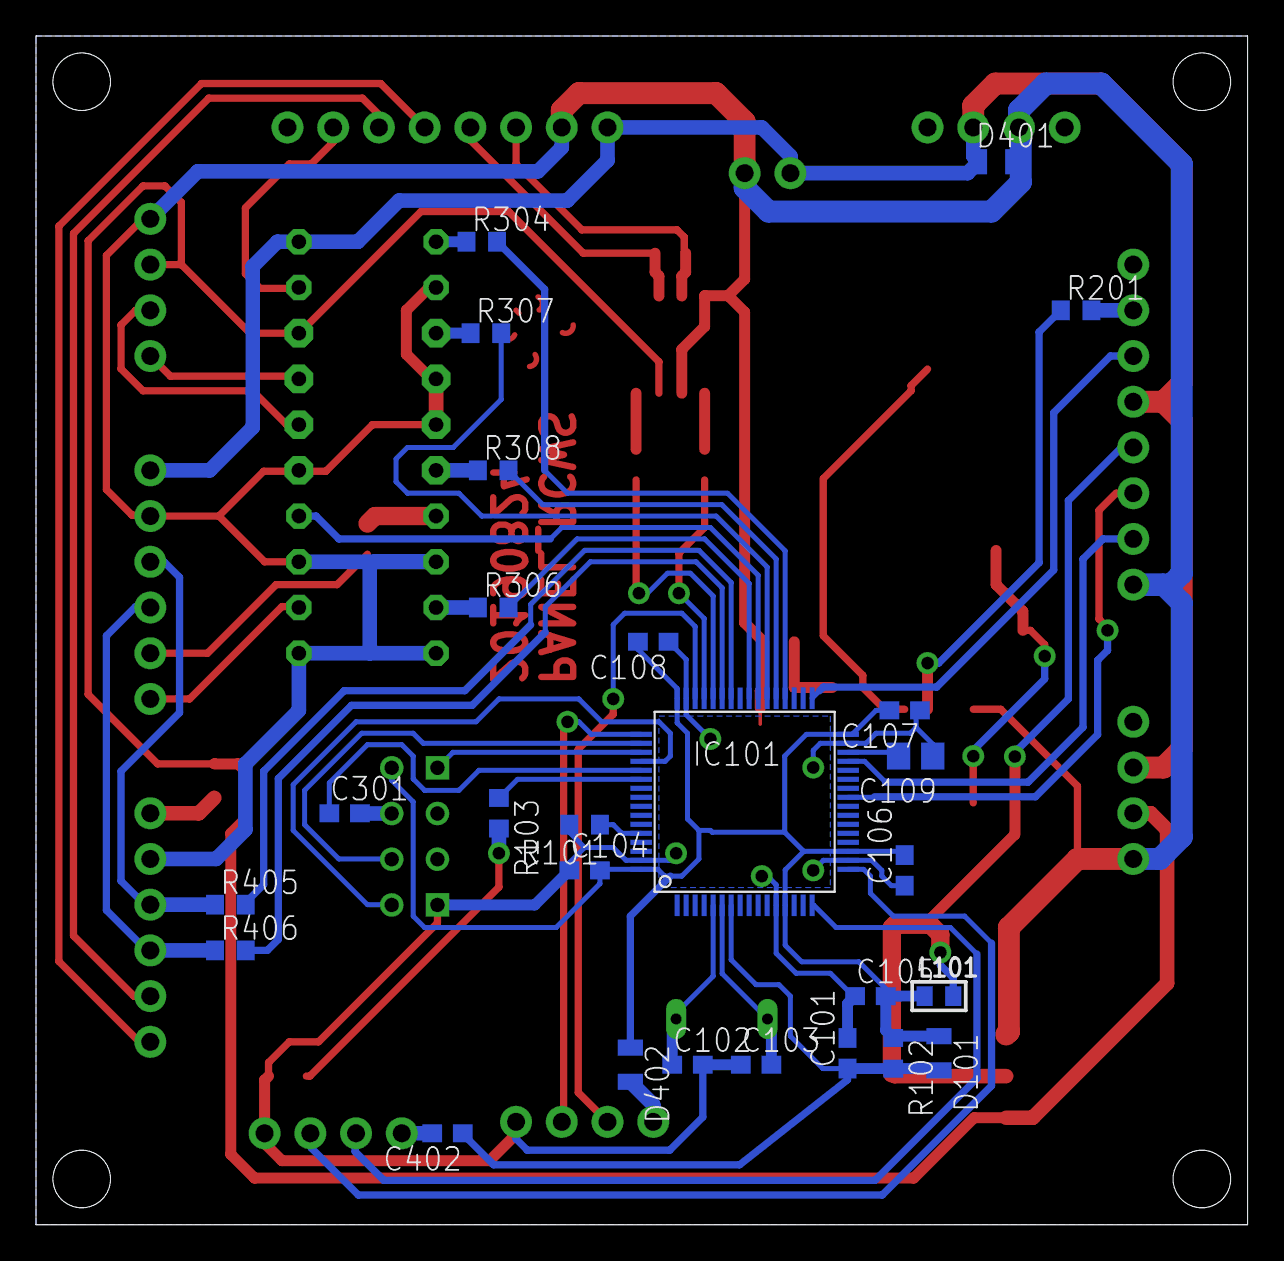
[picture p13: board panel446.brd from below]

Board: 2 copper layers, 67.3 x 66.0 mm, 59 parts (27 on the bottom side), 61 nets.
