kurrosetra/RCWS-FA/Optronik/Boards/Optronik.brd

## EAGLE design Optronik/Boards/Optronik.brd (2018-11-19)

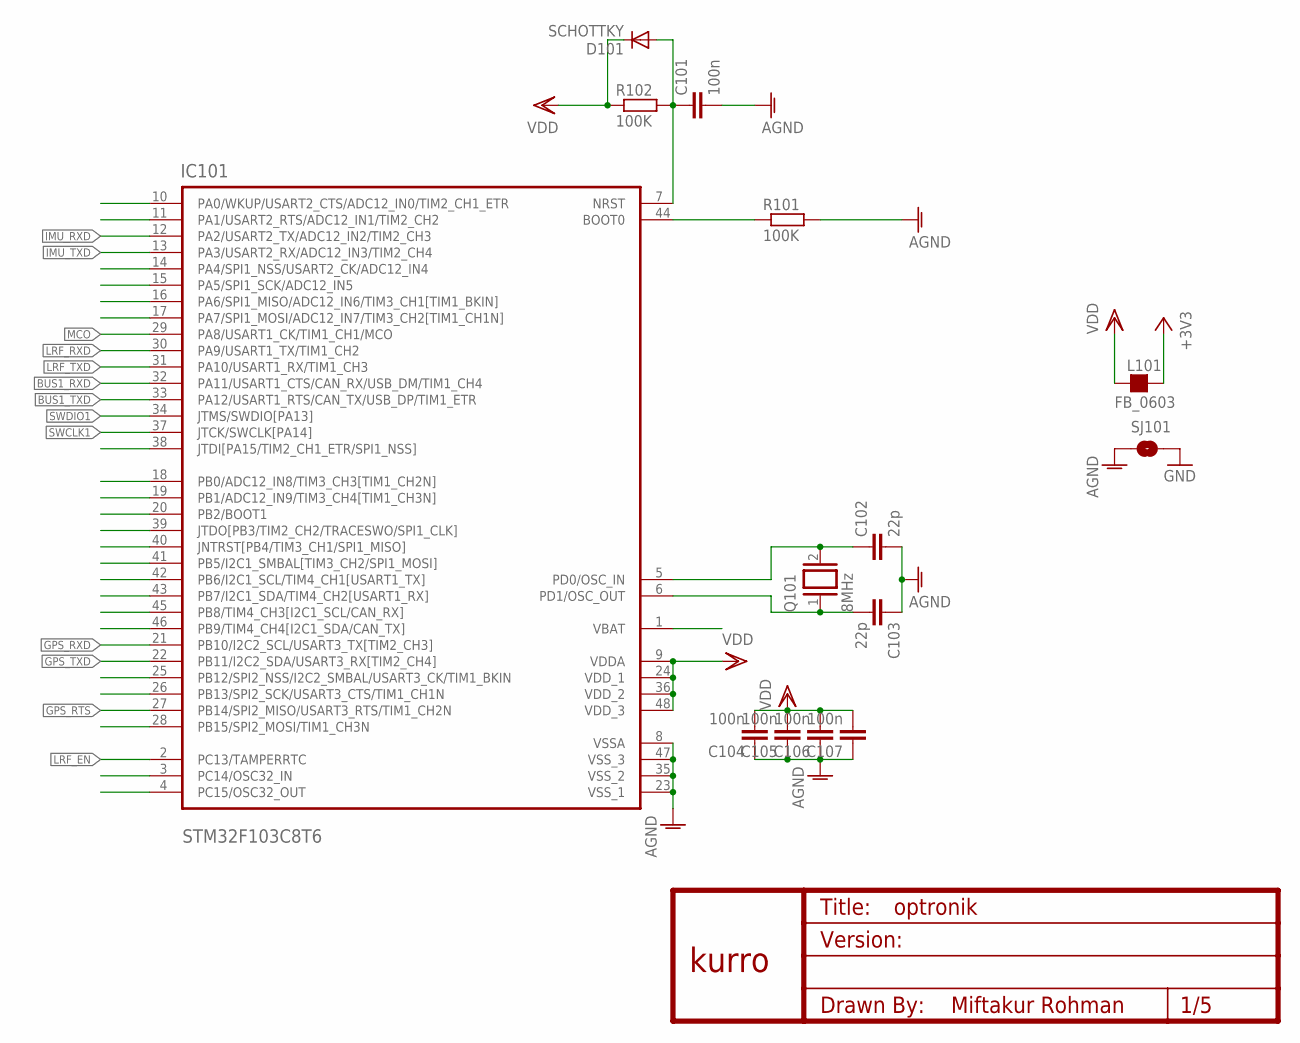
[picture p14: schematic Optronik.sch, sheet 1, MCU_MAIN]

Parts:
C101, C104, C105, C106, C107: 100n; C0603
C102, C103: 22p; C0603
D101: SCHOTTKY; MICROMELF-W
IC101: STM32F103C8T6; QFP50P900X900X160-48N
L101: FB_0603; L0603
Q101: 8MHz; QS
R101, R102: 100K; R0603
SJ101: SOLDERJUMPERTRACE; SJ_2S-TRACE
U$1: KURRO_FOOTPRINT; KURRO-LOGO

Connections:
+3V3: L101.2; also elsewhere on the board
AGND: C101.2, C102.2, C103.1, C104.1, C105.1, C106.1, C107.1, IC101.8 (VSSA), IC101.23 (VSS_1), IC101.35 (VSS_2), IC101.47 (VSS_3), R101.2, SJ101.1
BOOT0: IC101.44 (BOOT0), R101.1
BUS1_RXD: IC101.32 (PA11/USART1_CTS/CAN_RX/USB_DM/TIM1_CH4); also elsewhere on the board
BUS1_TXD: IC101.33 (PA12/USART1_RTS/CAN_TX/USB_DP/TIM1_ETR); also elsewhere on the board
GND: SJ101.2; also elsewhere on the board
GPS_RTS: IC101.27 (PB14/SPI2_MISO/USART3_RTS/TIM1_CH2N); also elsewhere on the board
GPS_RXD: IC101.21 (PB10/I2C2_SCL/USART3_TX[TIM2_CH3]); also elsewhere on the board
GPS_TXD: IC101.22 (PB11/I2C2_SDA/USART3_RX[TIM2_CH4]); also elsewhere on the board
IMU_RXD: IC101.12 (PA2/USART2_TX/ADC12_IN2/TIM2_CH3); also elsewhere on the board
IMU_TXD: IC101.13 (PA3/USART2_RX/ADC12_IN3/TIM2_CH4); also elsewhere on the board
LRF_EN: IC101.2 (PC13/TAMPERRTC); also elsewhere on the board
LRF_RXD: IC101.30 (PA9/USART1_TX/TIM1_CH2); also elsewhere on the board
LRF_TXD: IC101.31 (PA10/USART1_RX/TIM1_CH3); also elsewhere on the board
MCO: IC101.29 (PA8/USART1_CK/TIM1_CH1/MCO); also elsewhere on the board
unnamed: C103.2, IC101.6 (PD1/OSC_OUT), Q101.1
unnamed: C102.1, IC101.5 (PD0/OSC_IN), Q101.2
RST: C101.1, D101.A, IC101.7 (NRST), R102.2
SWCLK1: IC101.37 (JTCK/SWCLK[PA14]); also elsewhere on the board
SWDIO1: IC101.34 (JTMS/SWDIO[PA13]); also elsewhere on the board
VDD: C104.2, C105.2, C106.2, C107.2, D101.C, IC101.9 (VDDA), IC101.24 (VDD_1), IC101.36 (VDD_2), IC101.48 (VDD_3), L101.1, R102.1; also elsewhere on the board

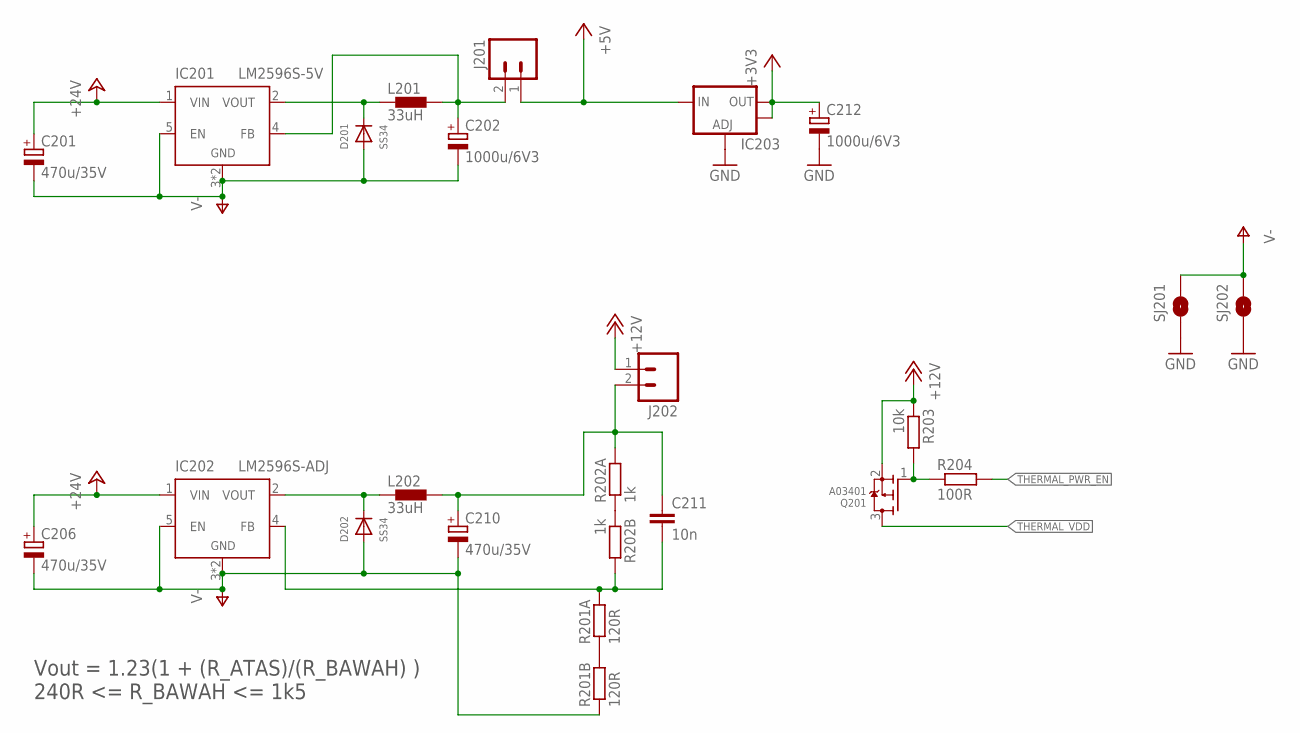
[picture p15: schematic Optronik.sch, sheet 2, PSU]

Parts:
C201, C206, C210: 470u/35V; 153CLV-1012
C202, C212: 1000u/6V3; 153CLV-0810
C211: 10n; C0603
D201, D202: SS34; SMADIODE
IC201: LM2596S-5V; D2PAK
IC202: LM2596S-ADJ; D2PAK
IC203: V_REG_LM1117SOT223; SOT223
J201, J202: M02-XH-VERT-SMD; XH-2-VERT-SMD
L201, L202: 33uH; PA4342
Q201: A03401; SOT23-W
R201A, R201B: 120R; R0603
R202A, R202B: 1k; R0603
R203: 10k; R0603
R204: 100R; R0603
SJ201, SJ202: SOLDERJUMPERTRACE; SJ_2S-TRACE

Connections:
+3V3: C212.+, IC203.2 (OUT), IC203.4 (OUT); also elsewhere on the board
+5V: IC203.3 (IN), J201.1; also elsewhere on the board
+12V: J202.1, Q201.2 (S), R203.1; also elsewhere on the board
+24V: C201.+, C206.+, IC201.1 (VIN), IC202.1 (VIN); also elsewhere on the board
FEED1: C211.2, IC202.4 (FB), R201A.2, R202B.2
GND: C212.-, IC203.1 (ADJ), SJ201.1, SJ202.1; also elsewhere on the board
unnamed: D201.C, IC201.2 (VOUT), L201.P$1 (1)
unnamed: D202.C, IC202.2 (VOUT), L202.P$1 (1)
unnamed: R201A.1, R201B.2
unnamed: R202A.1, R202B.1
unnamed: C202.+, IC201.4 (FB), J201.2, L201.P$2 (2)
unnamed: Q201.1 (G), R203.2, R204.1
unnamed: C210.+, C211.1, J202.2, L202.P$2 (2), R202A.2
THERMAL_PWR_EN: R204.2; also elsewhere on the board
THERMAL_VDD: Q201.3 (D); also elsewhere on the board
V-: C201.-, C202.-, C206.-, C210.-, D201.A, D202.A, IC201.3 (GND), IC201.5 (EN), IC201.6 (GND), IC202.3 (GND), IC202.5 (EN), IC202.6 (GND), R201B.1, SJ201.2, SJ202.2; also elsewhere on the board

Notes on the sheet:
Vout = 1.23(1 + (R_ATAS)/(R_BAWAH) ) 240R <= R_BAWAH <= 1k5

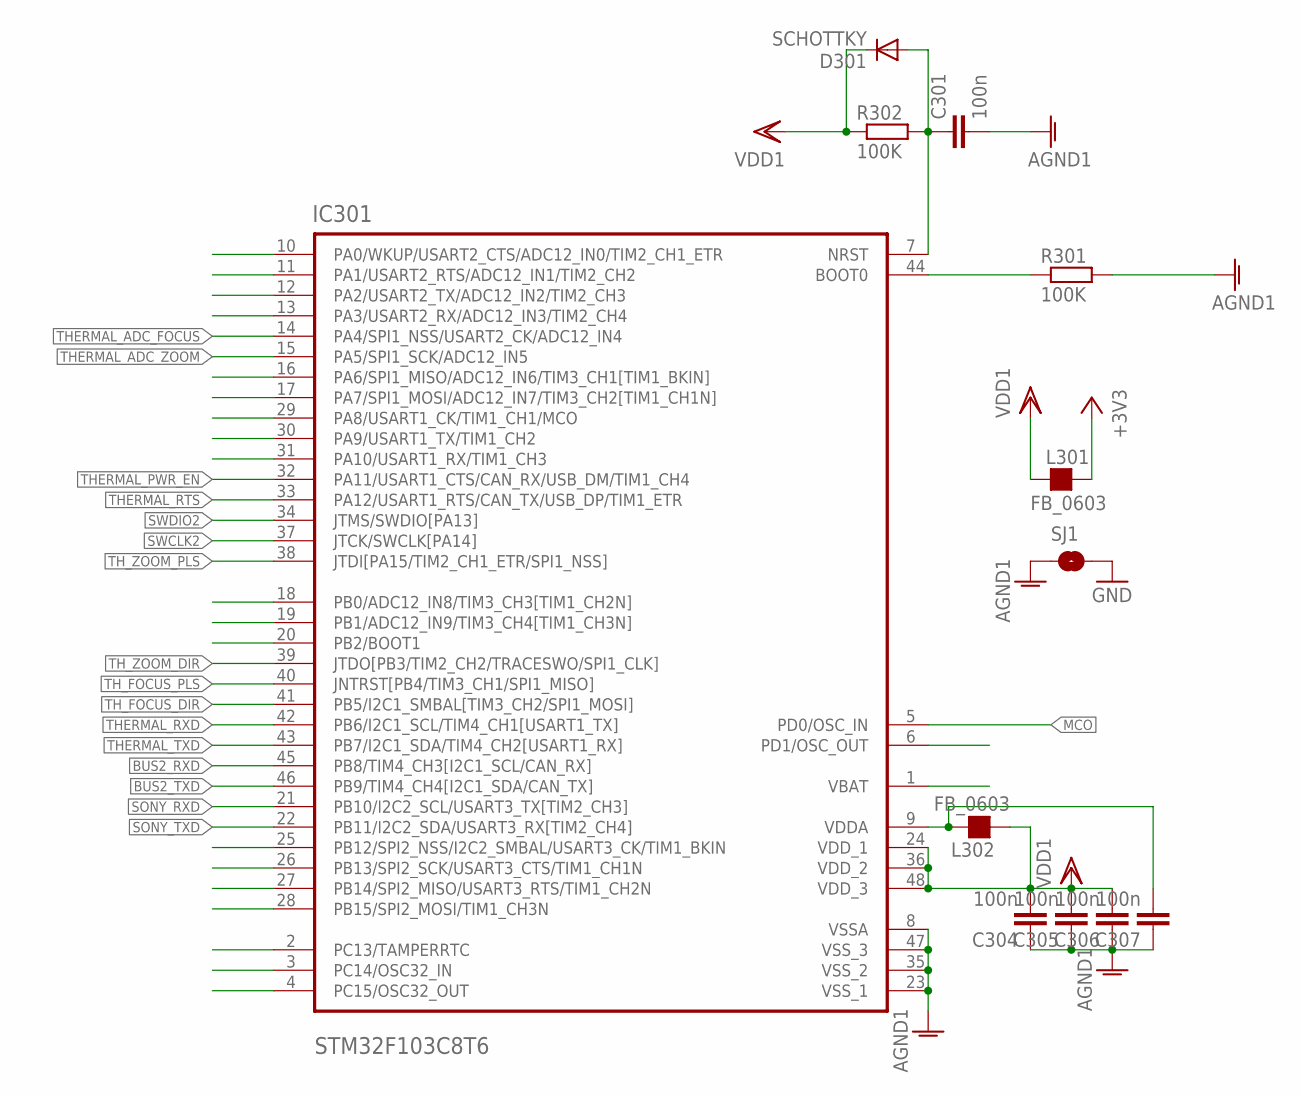
[picture p16: schematic Optronik.sch, sheet 3, MCU_CAM]

Parts:
C301, C304, C305, C306, C307: 100n; C0603
D301: SCHOTTKY; MICROMELF-W
IC301: STM32F103C8T6; QFP50P900X900X160-48N
L301, L302: FB_0603; L0603
R301, R302: 100K; R0603
SJ1: SOLDERJUMPERTRACE; SJ_2S-TRACE

Connections:
+3V3: L301.2; also elsewhere on the board
AGND1: C301.2, C304.1, C305.1, C306.1, C307.1, IC301.8 (VSSA), IC301.23 (VSS_1), IC301.35 (VSS_2), IC301.47 (VSS_3), R301.2, SJ1.1; also elsewhere on the board
BOOT1: IC301.44 (BOOT0), R301.1
BUS2_RXD: IC301.45 (PB8/TIM4_CH3[I2C1_SCL/CAN_RX]); also elsewhere on the board
BUS2_TXD: IC301.46 (PB9/TIM4_CH4[I2C1_SDA/CAN_TX]); also elsewhere on the board
GND: SJ1.2; also elsewhere on the board
MCO: IC301.5 (PD0/OSC_IN); also elsewhere on the board
RST1: C301.1, D301.A, IC301.7 (NRST), R302.2
SONY_RXD: IC301.21 (PB10/I2C2_SCL/USART3_TX[TIM2_CH3]); also elsewhere on the board
SONY_TXD: IC301.22 (PB11/I2C2_SDA/USART3_RX[TIM2_CH4]); also elsewhere on the board
SWCLK2: IC301.37 (JTCK/SWCLK[PA14]); also elsewhere on the board
SWDIO2: IC301.34 (JTMS/SWDIO[PA13]); also elsewhere on the board
THERMAL_ADC_FOCUS: IC301.14 (PA4/SPI1_NSS/USART2_CK/ADC12_IN4); also elsewhere on the board
THERMAL_ADC_ZOOM: IC301.15 (PA5/SPI1_SCK/ADC12_IN5); also elsewhere on the board
THERMAL_PWR_EN: IC301.32 (PA11/USART1_CTS/CAN_RX/USB_DM/TIM1_CH4); also elsewhere on the board
THERMAL_RTS: IC301.33 (PA12/USART1_RTS/CAN_TX/USB_DP/TIM1_ETR); also elsewhere on the board
THERMAL_RXD: IC301.42 (PB6/I2C1_SCL/TIM4_CH1[USART1_TX]); also elsewhere on the board
THERMAL_TXD: IC301.43 (PB7/I2C1_SDA/TIM4_CH2[USART1_RX]); also elsewhere on the board
TH_FOCUS_DIR: IC301.41 (PB5/I2C1_SMBAL[TIM3_CH2/SPI1_MOSI]); also elsewhere on the board
TH_FOCUS_PLS: IC301.40 (JNTRST[PB4/TIM3_CH1/SPI1_MISO]); also elsewhere on the board
TH_ZOOM_DIR: IC301.39 (JTDO[PB3/TIM2_CH2/TRACESWO/SPI1_CLK]); also elsewhere on the board
TH_ZOOM_PLS: IC301.38 (JTDI[PA15/TIM2_CH1_ETR/SPI1_NSS]); also elsewhere on the board
VDD1: C304.2, C305.2, C306.2, D301.C, IC301.24 (VDD_1), IC301.36 (VDD_2), IC301.48 (VDD_3), L301.1, L302.1, R302.1; also elsewhere on the board
VDDA1: C307.2, IC301.9 (VDDA), L302.2

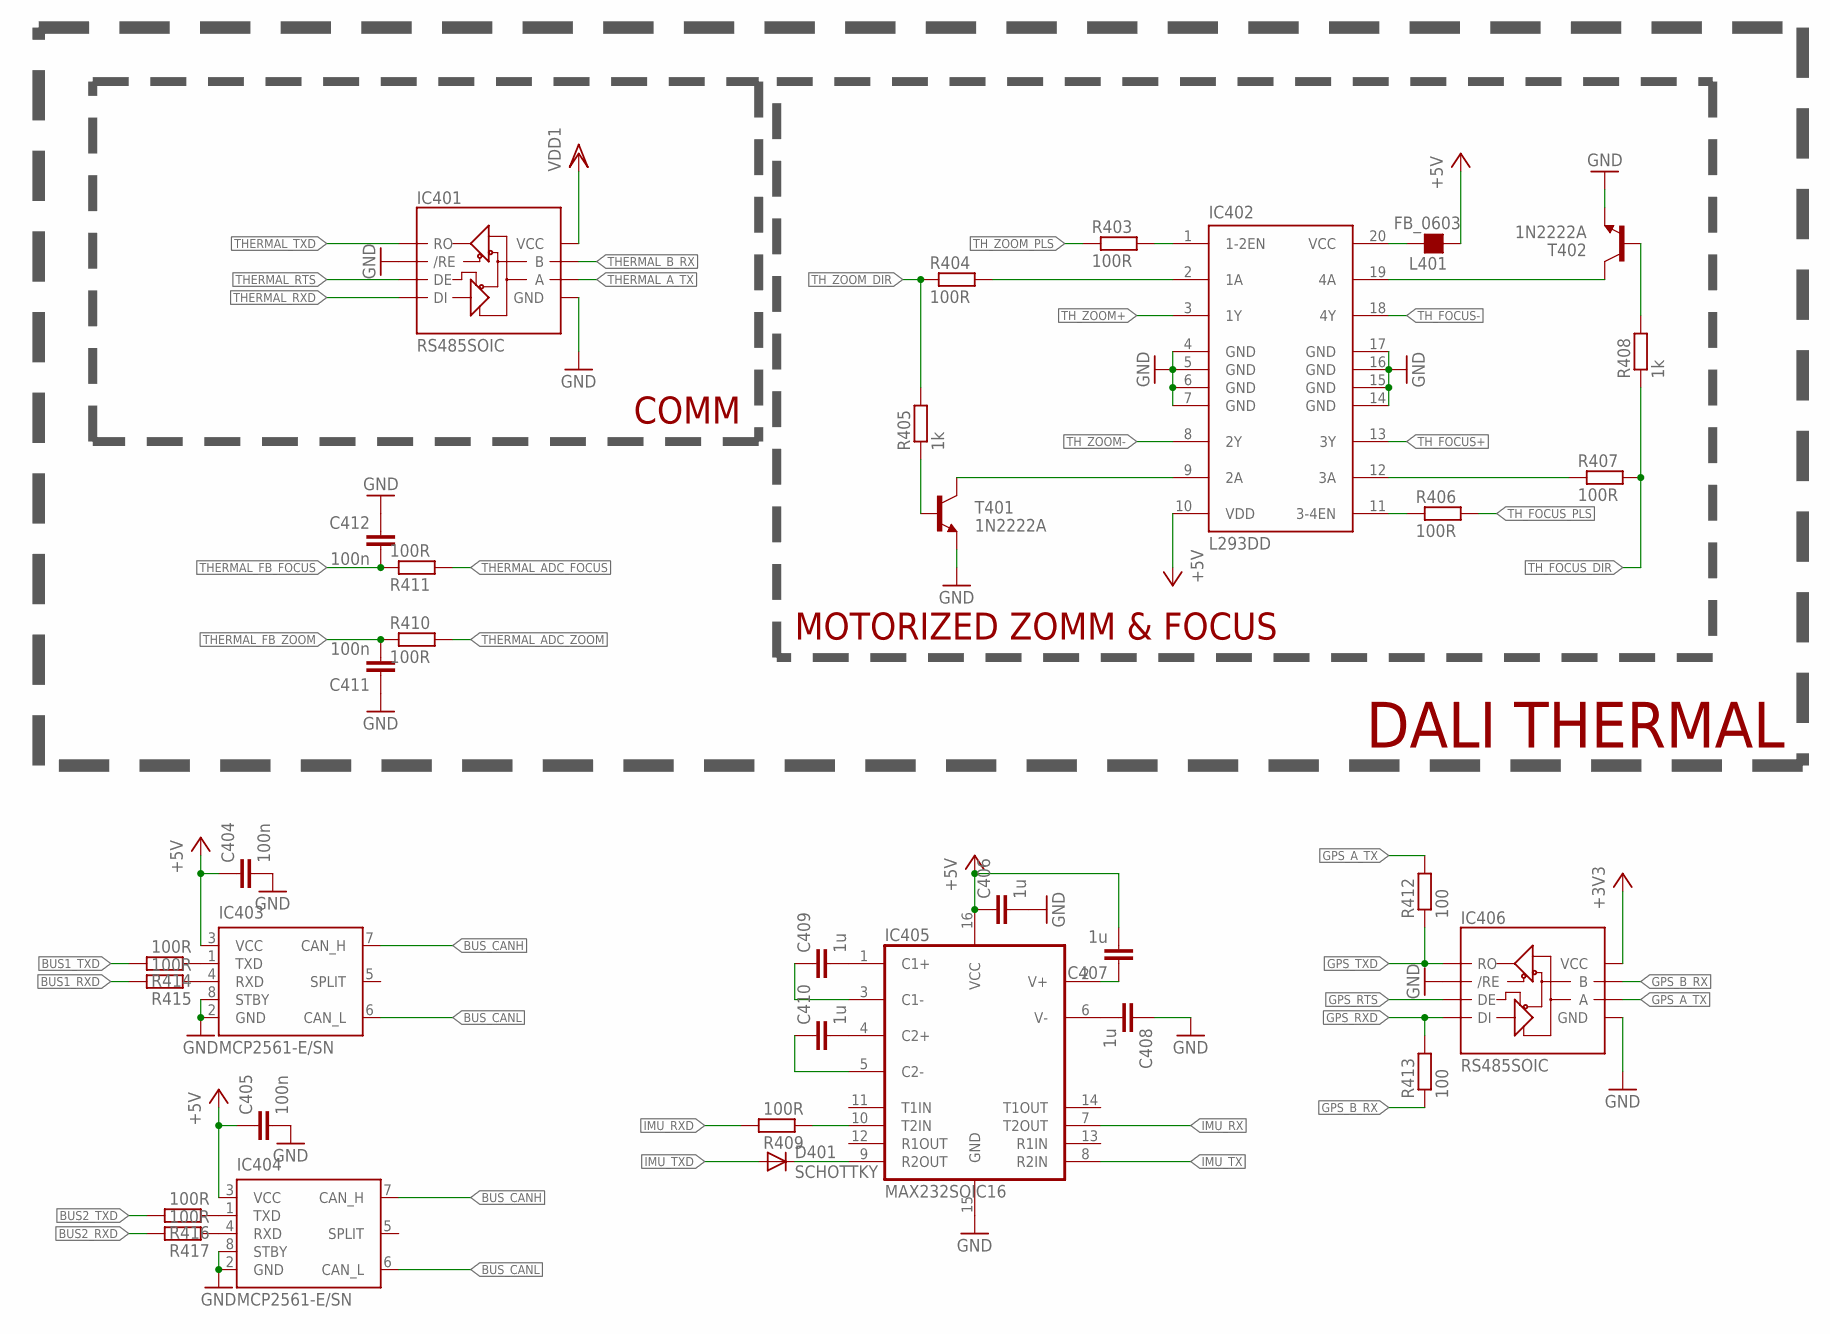
[picture p17: schematic Optronik.sch, sheet 4]

Parts:
C404, C405, C411, C412: 100n; C0603
C406, C407, C408, C409, C410: 1u; C0603
D401: SCHOTTKY; MICROMELF-W
IC401, IC406: RS485SOIC; SO08
IC402: L293DD; SO20W
IC403, IC404: MCP2561-E/SN; SOIC-8
IC405: MAX232SOIC16; SO016
L401: FB_0603; L0603
R403, R404, R406, R407, R409, R410, R411, R414, R415, R416, R417: 100R; R0603
R405, R408: 1k; R0603
R412, R413: 100; R0603
T401, T402: 1N2222A; SOT23

Connections:
+3V3: IC406.8 (VCC); also elsewhere on the board
+5V: C404.1, C405.1, C406.1, C407.2, IC402.10 (VDD), IC403.3 (VCC), IC404.3 (VCC), IC405.16 (VCC), L401.1; also elsewhere on the board
BUS1_RXD: R415.2; also elsewhere on the board
BUS1_TXD: R414.2; also elsewhere on the board
BUS2_RXD: R417.2; also elsewhere on the board
BUS2_TXD: R416.2; also elsewhere on the board
BUS_CANH: IC403.7 (CAN_H), IC404.7 (CAN_H); also elsewhere on the board
BUS_CANL: IC403.6 (CAN_L), IC404.6 (CAN_L); also elsewhere on the board
GND: C404.2, C405.2, C406.2, C408.1, C411.1, C412.1, IC401.2 (/RE), IC401.5 (GND), IC402.4 (GND), IC402.5 (GND), IC402.6 (GND), IC402.7 (GND), IC402.14 (GND), IC402.15 (GND), IC402.16 (GND), IC402.17 (GND), IC403.2 (GND), IC403.8 (STBY), IC404.2 (GND), IC404.8 (STBY), IC405.15 (GND), IC406.2 (/RE), IC406.5 (GND), T401.2 (E), T402.2 (E); also elsewhere on the board
GPS_A_TX: IC406.6 (A), R412.2; also elsewhere on the board
GPS_B_RX: IC406.7 (B), R413.1; also elsewhere on the board
GPS_RTS: IC406.3 (DE); also elsewhere on the board
GPS_RXD: IC406.4 (DI), R413.2; also elsewhere on the board
GPS_TXD: IC406.1 (RO), R412.1; also elsewhere on the board
IMU_RX: IC405.7 (T2OUT); also elsewhere on the board
IMU_RXD: R409.2; also elsewhere on the board
IMU_TX: IC405.8 (R2IN); also elsewhere on the board
IMU_TXD: D401.A; also elsewhere on the board
unnamed: IC402.20 (VCC), L401.2
unnamed: C408.2, IC405.6 (V-)
unnamed: C409.2, IC405.1 (C1+)
unnamed: C410.2, IC405.4 (C2+)
unnamed: IC402.12 (3A), R407.1
unnamed: IC403.1 (TXD), R414.1
unnamed: IC402.2 (1A), R404.2
unnamed: IC403.4 (RXD), R415.1
unnamed: C409.1, IC405.3 (C1-)
unnamed: C410.1, IC405.5 (C2-)
unnamed: IC404.1 (TXD), R416.1
unnamed: C407.1, IC405.2 (V+)
unnamed: IC404.4 (RXD), R417.1
unnamed: IC405.10 (T2IN), R409.1
unnamed: D401.C, IC405.9 (R2OUT)
unnamed: IC402.1 (1-2EN), R403.2
unnamed: IC402.11 (3-4EN), R406.1
unnamed: R405.1, T401.1 (B)
unnamed: IC402.9 (2A), T401.3 (C)
unnamed: IC402.19 (4A), T402.3 (C)
unnamed: R408.2, T402.1 (B)
THERMAL_ADC_FOCUS: R411.2; also elsewhere on the board
THERMAL_ADC_ZOOM: R410.2; also elsewhere on the board
THERMAL_A_TX: IC401.6 (A); also elsewhere on the board
THERMAL_B_RX: IC401.7 (B); also elsewhere on the board
THERMAL_FB_FOCUS: C412.2, R411.1; also elsewhere on the board
THERMAL_FB_ZOOM: C411.2, R410.1; also elsewhere on the board
THERMAL_RTS: IC401.3 (DE); also elsewhere on the board
THERMAL_RXD: IC401.4 (DI); also elsewhere on the board
THERMAL_TXD: IC401.1 (RO); also elsewhere on the board
TH_FOCUS+: IC402.13 (3Y); also elsewhere on the board
TH_FOCUS-: IC402.18 (4Y); also elsewhere on the board
TH_FOCUS_DIR: R407.2, R408.1; also elsewhere on the board
TH_FOCUS_PLS: R406.2; also elsewhere on the board
TH_ZOOM+: IC402.3 (1Y); also elsewhere on the board
TH_ZOOM-: IC402.8 (2Y); also elsewhere on the board
TH_ZOOM_DIR: R404.1, R405.2; also elsewhere on the board
TH_ZOOM_PLS: R403.1; also elsewhere on the board
VDD1: IC401.8 (VCC); also elsewhere on the board

Notes on the sheet:
DALI THERMAL
COMM
MOTORIZED ZOMM & FOCUS

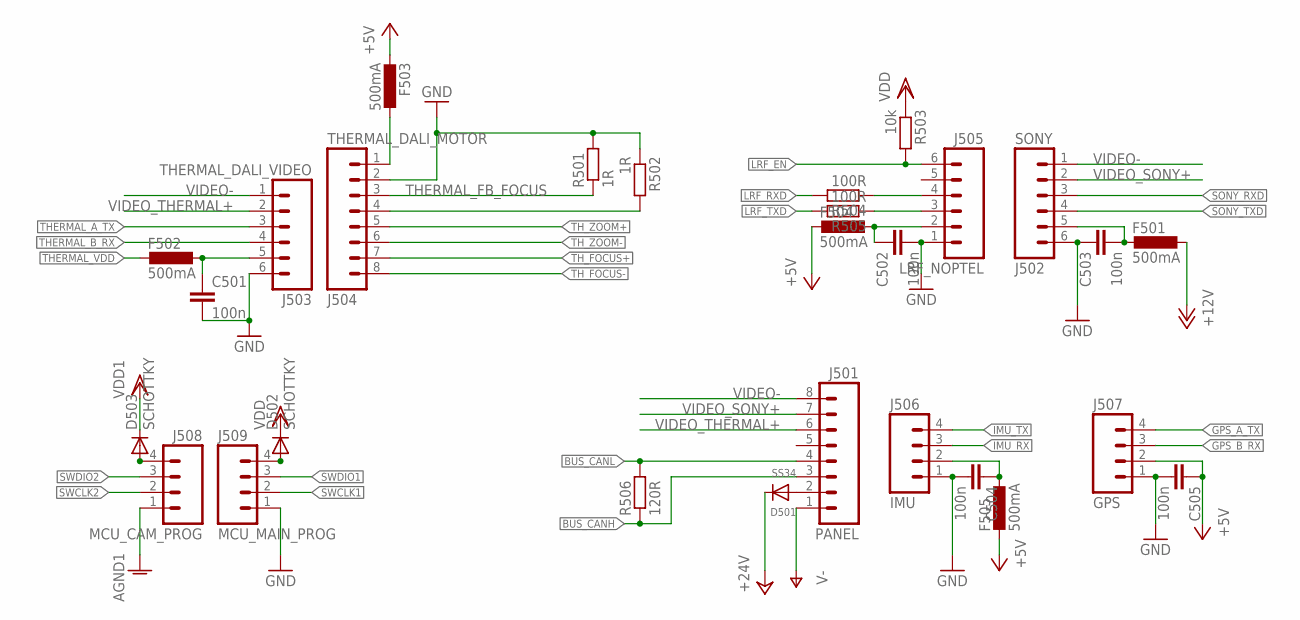
[picture p18: schematic Optronik.sch, sheet 5, CONNECTOR]

Parts:
C501, C502, C503, C504, C505: 100n; C0603
D501: SS34; SMADIODE
D502, D503: SCHOTTKY; MICROMELF-W
F501, F502, F503, F504, F505: 500mA; L0805
J501: PANEL; XH-8-RA
J502: SONY; XH-6-RA
J503: THERMAL_DALI_VIDEO; XH-6-RA
J504: THERMAL_DALI_MOTOR; XH-8-RA
J505: LRF_NOPTEL; XH-6-RA
J506: IMU; XH-4-RA
J507: GPS; XH-4-RA
J508: MCU_CAM_PROG; XH-4-VERT
J509: MCU_MAIN_PROG; XH-4-VERT
R501, R502: 1R; 0411V
R503: 10k; R0603
R504, R505: 100R; R0603
R506: 120R; R0603

Connections:
+5V: C505.1, F503.2, F504.2, F505.2, J507.2; also elsewhere on the board
+12V: F501.1; also elsewhere on the board
+24V: D501.C; also elsewhere on the board
AGND1: J508.1; also elsewhere on the board
BUS_CANH: J501.3, R506.1; also elsewhere on the board
BUS_CANL: J501.4, R506.2; also elsewhere on the board
GND: C501.2, C502.2, C503.1, C504.2, C505.2, J502.6, J503.6, J504.2, J505.1, J506.1, J507.1, J509.1, R501.2, R502.1; also elsewhere on the board
GPS_A_TX: J507.4; also elsewhere on the board
GPS_B_RX: J507.3; also elsewhere on the board
IMU_RX: J506.3; also elsewhere on the board
IMU_TX: J506.4; also elsewhere on the board
LRF_EN: J505.6, R503.2; also elsewhere on the board
LRF_RXD: R504.2; also elsewhere on the board
LRF_TXD: R505.2; also elsewhere on the board
unnamed: D501.A, J501.2
unnamed: F503.1, J504.1
unnamed: D502.A, J509.4
unnamed: C501.1, F502.1, J503.5
unnamed: C502.1, F504.1, J505.2
unnamed: C503.2, F501.2, J502.5
unnamed: C504.1, F505.1, J506.2
unnamed: J505.3, R505.1
unnamed: J505.4, R504.1
unnamed: D503.A, J508.4
SONY_RXD: J502.3; also elsewhere on the board
SONY_TXD: J502.4; also elsewhere on the board
SWCLK1: J509.2; also elsewhere on the board
SWCLK2: J508.2; also elsewhere on the board
SWDIO1: J509.3; also elsewhere on the board
SWDIO2: J508.3; also elsewhere on the board
THERMAL_A_TX: J503.3; also elsewhere on the board
THERMAL_B_RX: J503.4; also elsewhere on the board
THERMAL_FB_FOCUS: J504.3, R501.1; also elsewhere on the board
THERMAL_FB_ZOOM: J504.4, R502.2; also elsewhere on the board
THERMAL_VDD: F502.2; also elsewhere on the board
TH_FOCUS+: J504.7; also elsewhere on the board
TH_FOCUS-: J504.8; also elsewhere on the board
TH_ZOOM+: J504.5; also elsewhere on the board
TH_ZOOM-: J504.6; also elsewhere on the board
V-: J501.1; also elsewhere on the board
VDD: D502.C, R503.1; also elsewhere on the board
VDD1: D503.C; also elsewhere on the board
VIDEO-: J501.8, J502.1, J503.1
VIDEO_SONY+: J501.7, J502.2
VIDEO_THERMAL+: J501.6, J503.2

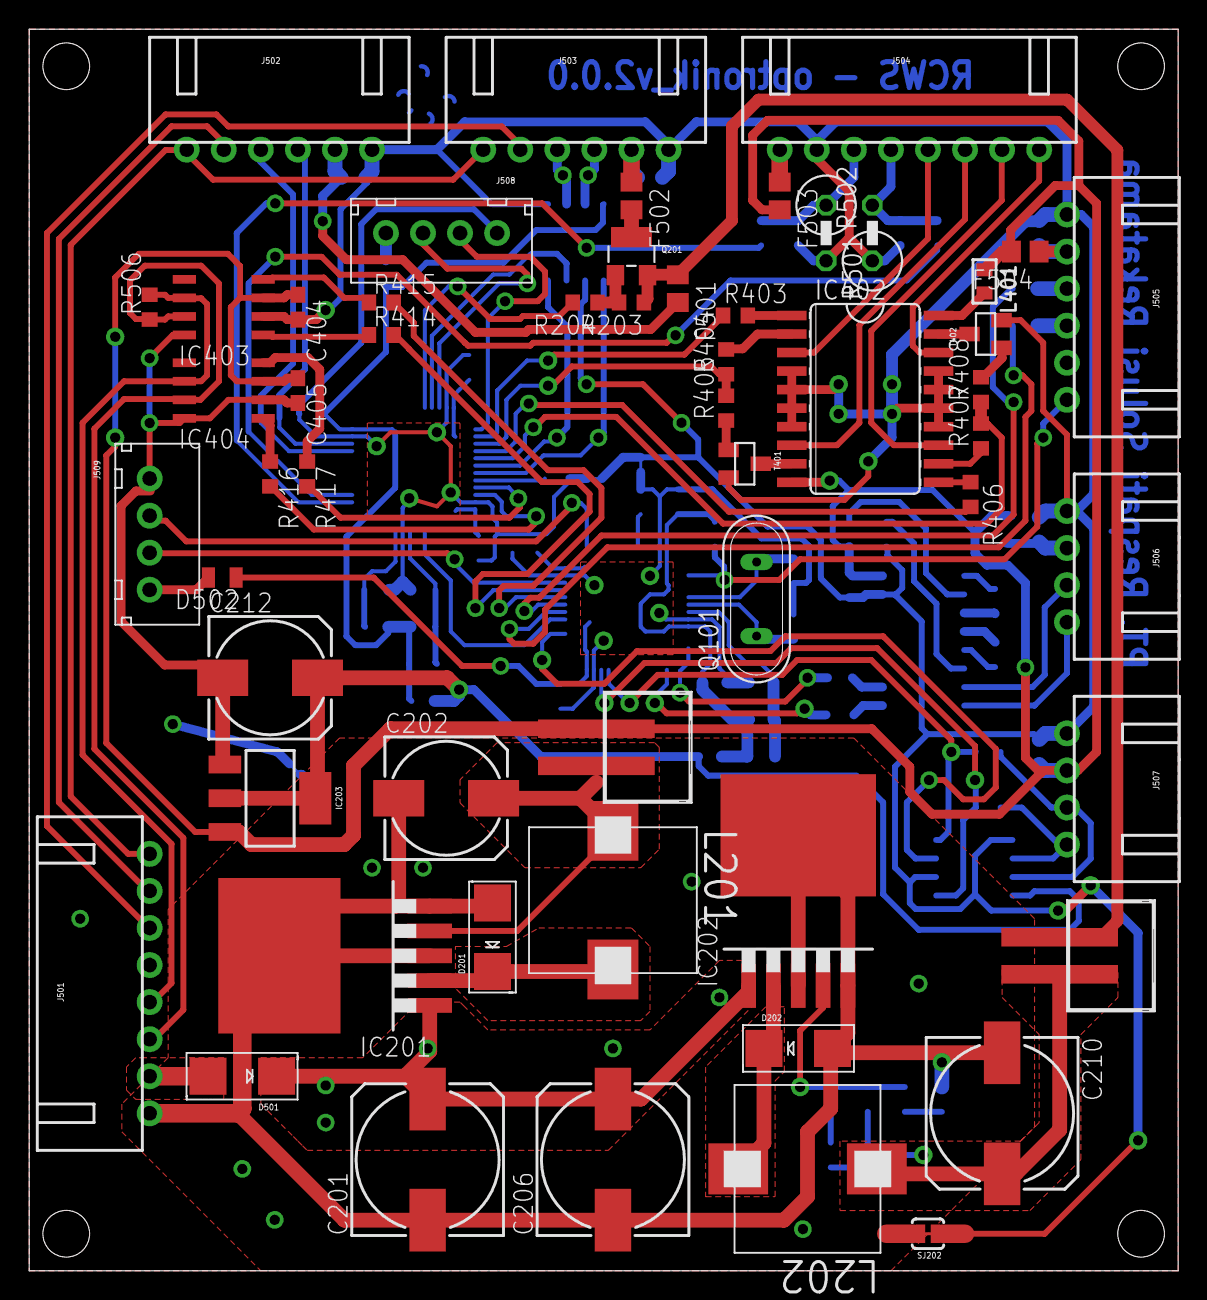
[picture p19: board Optronik.brd from above]

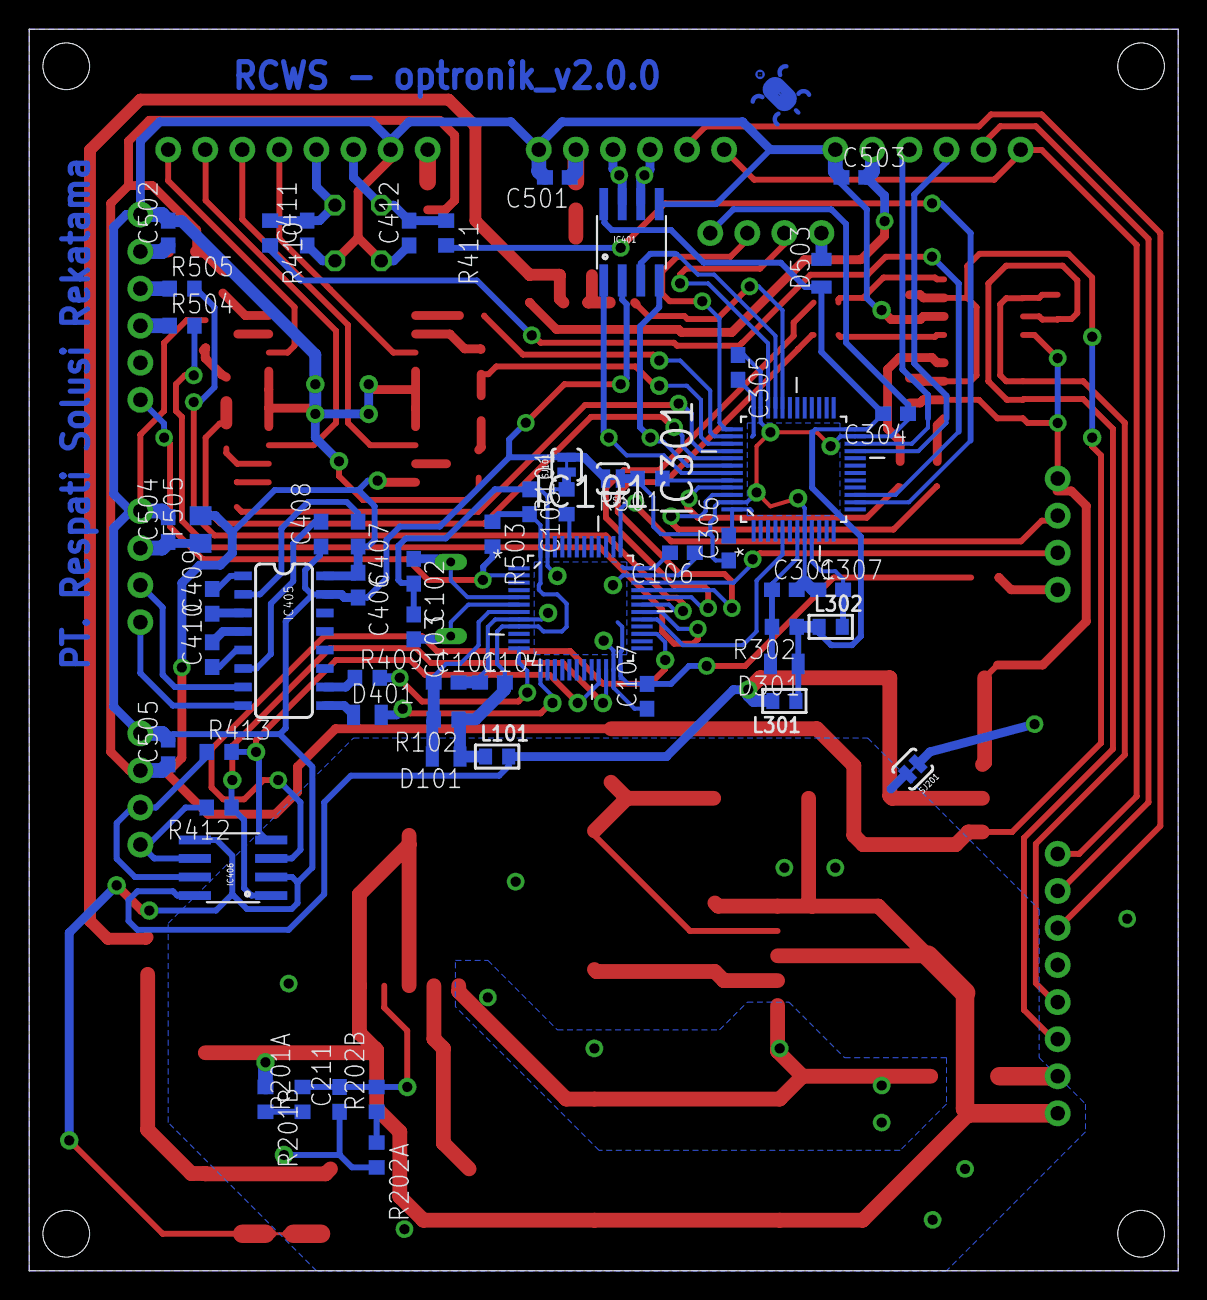
[picture p20: board Optronik.brd from below]

Board: 2 copper layers, 78.7 x 85.1 mm, 113 parts (57 on the bottom side), 103 nets.
