kurrosetra/RCWS-FA/MotorControl/Firmwares/motorController/Src/main.c

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
/* Includes ------------------------------------------------------------------*/
#include "main.h"

/* USER CODE BEGIN Includes */
#include <stdlib.h>
#include <stdio.h>
#include <string.h>

#include "rwsCanID.h"
#include "stm_hal_serial.h"
#include "Ingenia_CanServoDriver.h"

/* USER CODE END Includes */

/* USER CODE BEGIN PTD */
typedef enum
{
	LIM_SWITCH_AZIMUTH_ZERO = 0,
	LIM_SWITCH_ELEVATION_UP,
	LIM_SWITCH_ELEVATION_DOWN
} LimitSwitchBit_e;

typedef enum
{
	MOVE_STAB_bit = 0,
	MOVE_TRACK_bit = 1
} MoveBit_e;

typedef enum
{
	MOVEMENT_MANUAL = 0,
	MOVEMENT_STABILIZE,
	MOVEMENT_TRACKING
} MovementState_e;

typedef union
{
	float f;
	uint32_t u32;
	int32_t i32;
	uint8_t b[4];
} Union_u;

typedef struct
{
	volatile uint32_t angleVelo[2];
	volatile uint32_t stabMode;
	volatile uint32_t manualCommand;
	volatile uint32_t stabCommand;
	volatile uint32_t trackCommand;
} CanRecvCounter_t;

/* USER CODE END PTD */

/* USER CODE BEGIN PD */
#define DEBUG					1

#if DEBUG==1
#	define DEBUG_MTR_POSVELO	0
#	define DEBUG_INGENIA_DRIVER	0
#	if DEBUG_INGENIA_DRIVER==1
#		define MTR_ID			0x20
#	endif	//if DEBUG_INGENIA_DRIVER==1
#endif	//if DEBUG==1

#define MTR_AZ_ENABLE			1
#define MTR_EL_ENABLE			1
#define MTR_COCK_ENABLE			0

#define MTR_AZ_ID				0x20
#define MTR_EL_ID				0x21
#define MTR_COCK_ID				0x22

#ifdef RING_BUFFER_SIZE
#define UART_BUFSIZE			RING_BUFFER_SIZE
#else
#define UART_BUFSIZE			256
#endif

#ifndef CAN_DATA_MAX
#define CAN_DATA_MAX		8
#endif

#define bitRead(value, bit) (((value) >> (bit)) & 0x01)
#define bitSet(value, bit) ((value) |= (1UL << (bit)))
#define bitClear(value, bit) ((value) &= ~(1UL << (bit)))
#define bitWrite(value, bit, bitvalue) (bitvalue ? bitSet(value, bit) : bitClear(value, bit))

#define MOTOR_MAX_SPEED			116500UL	//1750RPM
#define MOTOR_MAX_ACCEL			2500000UL

#define TPDO4_EVENT_TIMER_100HZ			10

#define MOTOR_UPDATE_TIMEOUT			10	//100HZ

/* USER CODE END PD */

CAN_HandleTypeDef hcan1;
CAN_HandleTypeDef hcan2;

IWDG_HandleTypeDef hiwdg;

TIM_HandleTypeDef htim3;

UART_HandleTypeDef huart6;

/* USER CODE BEGIN PV */
/* TODO Global Variables*/
uint16_t bufLen = 0;
char buf[UART_BUFSIZE];

#if DEBUG
Ring_Buffer_t tx6Buffer = { { 0 }, 0, 0 };
Ring_Buffer_t rx6Buffer = { { 0 }, 0, 0 };
TSerial debug = { &rx6Buffer, &tx6Buffer, &huart6 };
#endif	//if DEBUG

#if DEBUG==1
char vt100_home[10];
#define DEBUG_LINE_MAX		25
char vt100_lineX[DEBUG_LINE_MAX][16];
#endif	//if DEBUG==1

CAN_TxHeaderTypeDef can2TxHeader;
uint32_t can2TxMailBox;
uint8_t can2TxBuffer[8];
CAN_RxHeaderTypeDef can2RxHeader;
uint8_t can2RxBuffer[8];

CAN_TxHeaderTypeDef *busTxHeader;
uint32_t *busTxMailBox;
uint8_t *busTxBuffer;
CAN_RxHeaderTypeDef *busRxHeader;
uint8_t *busRxBuffer;

#if DEBUG_INGENIA_DRIVER==1
Servo_t mtr;
Servo_t dummy;
#endif	//if DEBUG_INGENIA_DRIVER==1

#if MTR_AZ_ENABLE==1
Servo_t mtrAzi;
#endif	//if MTR_AZ_ENABLE==1

#if MTR_EL_ENABLE==1
Servo_t mtrEle;
#endif	//if MTR_EL_ENABLE==1

#if MTR_COCK_ENABLE==1
servo_t mtrCock;
#endif	//if MTR_COCK_ENABLE==1

volatile uint8_t limitSwitch = 0;

int32_t manualCommand[2] = { 0, 0 };
int32_t stabCommand[2] = { 0, 0 };
int32_t trackCommand[2] = { 0, 0 };
int32_t *panCommand = &manualCommand[0], *tiltCommand = &manualCommand[1];
volatile bool cockStart = false;

typedef enum
{
	SERVO_PAN,
	SERVO_TILT
} EServoName;

typedef enum
{
	DIR_UP_RIGHT = false,
	DIR_DOWN_LEFT = true
} EServoDirection;

typedef struct
{
	EServoName name;
	volatile bool enable;
	Servo_t *servo;
	uint32_t prevSpeed;
	bool direction;
	float relPosition;
	float velo;
} TServoState;
TServoState pan;
TServoState tilt;

#define CAN_BUFSIZE							8
const uint32_t COMMAND_RECEIVE_TIMEOUT = 500;

typedef struct
{
	uint32_t id;
	volatile bool state;
	uint8_t data[8];
	uint8_t size;
	uint8_t online;
} TCanRecvBuffer;

typedef struct
{
	uint32_t id;
	uint8_t data[8];
	uint8_t size;
} TCanSendBuffer;

TCanRecvBuffer canRecvPanel = { CAN_ID_RWS_PNL_MTR, false, { 0 }, 8, 0 };
TCanRecvBuffer canRecvButton = { CAN_ID_RWS_BUTTON, false, { 0 }, 3, 0 };
TCanRecvBuffer canRecvMoveMode = { CAN_ID_RWS_PNL_STAB_MODE, false, { 0 }, 6, 0 };
TCanRecvBuffer canRecvStabCommand = { CAN_ID_RWS_STAB_MTR_STB, false, { 0 }, 8, 0 };
TCanRecvBuffer canRecvTrackCommand = { CAN_ID_RWS_STAB_MTR_TRK, false, { 0 }, 8, 0 };

TCanSendBuffer canSendMotor = { CAN_ID_RWS_MOTOR, { 0 }, 6 };
TCanSendBuffer canSendMotorAngle = { CAN_ID_RWS_MTR_STAB_ANGLE, { 0 }, 8 };
TCanSendBuffer canSendMotorSpeed = { CAN_ID_RWS_MTR_STAB_SPD, { 0 }, 8 };

#if DEBUG_MTR_POSVELO==1
volatile uint32_t countTPDO4 = 0;
#endif	//if DEBUG_MTR_POSVELO==1
CanRecvCounter_t crCounter = { { 0, 0 }, 0, 0, 0, 0 };
uint8_t moveState = MOVEMENT_MANUAL;

/* USER CODE END PV */

void SystemClock_Config(void);
static void MX_GPIO_Init(void);
static void MX_CAN1_Init(void);
static void MX_CAN2_Init(void);
static void MX_IWDG_Init(void);
static void MX_USART6_UART_Init(void);
static void MX_TIM3_Init(void);
/* USER CODE BEGIN PFP */
#if DEBUG_INGENIA_DRIVER==1
static void displayCanBuffer(CAN_Data_t *data);
static void debugMotor();
#endif	//if DEBUG_INGENIA_DRIVER==1

static HAL_StatusTypeDef motorInit();
static void motorStop(TServoState *motor);
static void motorSpeed(TServoState *motor, int32_t spd);
static void motorHandler();

static HAL_StatusTypeDef busInit();
static void manualCommandParsing();
static void stabCommandParsing();
static void trackCommandParsing();
static void busHandler(CAN_HandleTypeDef *bus);
static void busSendingHandler();
static void busExpirationHandler();
/* USER CODE END PFP */

/**
 * @brief  The application entry point.
 * @retval int
 */
int main(void)
{
	/* MCU Configuration--------------------------------------------------------*/

	/* Reset of all peripherals, Initializes the Flash interface and the Systick. */
	HAL_Init();

	/* Configure the system clock */
	SystemClock_Config();

	/* USER CODE BEGIN SysInit */
#if DEBUG==1
	sprintf(vt100_home, "\x1b[2J\x1b[H");
	unsigned char debugLine = 0;
	for ( debugLine = 0; debugLine < DEBUG_LINE_MAX; debugLine++ )
		sprintf(vt100_lineX[debugLine], "\x1b[%d;0H\x1b[2K", debugLine);
#endif	//if DEBUG==1
	/* USER CODE END SysInit */

	/* Initialize all configured peripherals */
	MX_GPIO_Init();
	MX_CAN1_Init();
	MX_CAN2_Init();
	MX_IWDG_Init();
	MX_USART6_UART_Init();
	MX_TIM3_Init();
	/* USER CODE BEGIN 2 */
	HAL_IWDG_Refresh(&hiwdg);

#if DEBUG==1
	serial_init(&debug);

	bufLen = sprintf(buf, "%sIngenia CAN library\r\n", vt100_home);
	serial_write_str(&debug, buf, bufLen);
#endif	//if DEBUG==1

#if DEBUG==1
	bufLen = sprintf(buf, "motor init...\r\n");
	serial_write_str(&debug, buf, bufLen);
#endif	//if DEBUG==1

	if (motorInit() != HAL_OK) {
		HAL_GPIO_WritePin(LED_BUILTIN_GPIO_Port, LED_BUILTIN_Pin, GPIO_PIN_RESET);
		while (1)
			;
	}
#if DEBUG==1
	bufLen = sprintf(buf, "done!\r\n");
	serial_write_str(&debug, buf, bufLen);

	bufLen = sprintf(buf, "bus init...");
	serial_write_str(&debug, buf, bufLen);
#endif	//if DEBUG==1

	if (busInit() != HAL_OK) {
		HAL_GPIO_WritePin(LED_BUILTIN_GPIO_Port, LED_BUILTIN_Pin, GPIO_PIN_RESET);
		while (1)
			;
	}

#if DEBUG==1
	bufLen = sprintf(buf, "done!\r\n");
	serial_write_str(&debug, buf, bufLen);
#endif	//if DEBUG==1

#if DEBUG_INGENIA_DRIVER==1
	debugMotor();
#endif	//if DEBUG_INGENIA_DRIVER==1

	/* USER CODE END 2 */

	/* Infinite loop */
	/* USER CODE BEGIN WHILE */
#if DEBUG_MTR_POSVELO==1
	uint32_t countTpdoTimer = 0;
	Union_u p, v;
#endif	//if DEBUG_INGENIA_DRIVER==1

#if DEBUG==1
	uint32_t dTimer = 0;
#endif	//if DEBUG==1

	while (1) {
		HAL_IWDG_Refresh(&hiwdg);
		/* USER CODE END WHILE */

		/* USER CODE BEGIN 3 */
		/* TODO BEGIN LOOP*/

		busExpirationHandler();
		motorHandler();
		busSendingHandler();

#if DEBUG==1
		if (HAL_GetTick() >= dTimer) {
			dTimer = HAL_GetTick() + 100;

			bufLen = sprintf(buf, "%s0x%02X st=%d;en=%d:%d\t%d:%d", vt100_lineX[8],
					canRecvMoveMode.data[0], moveState, pan.enable, tilt.enable, *panCommand,
					*tiltCommand);
			serial_write_str(&debug, buf, bufLen);
		}
#endif	//if DEBUG==1

#if DEBUG_MTR_POSVELO==1
		uint8_t _dataRpdo[8];
		if (HAL_GetTick() >= countTpdoTimer) {
			countTpdoTimer = HAL_GetTick() + 1000;

			bufLen = sprintf(buf, "%stpdo4= %d/s", vt100_lineX[11], countTPDO4);
			countTPDO4 = 0;
			serial_write_str(&debug, buf, bufLen);
		}

		if (serial_available(&debug)) {
			char c = serial_read(&debug);

			if (c == 'T') {
				bufLen = sprintf(buf, "%smotor enable\r\n", vt100_lineX[12]);
				serial_write_str(&debug, buf, bufLen);
				_dataRpdo[0] = 0xF;
				_dataRpdo[1] = 0;
				Ingenia_write_rpdo(tilt.servo, COB_RPDO1, _dataRpdo, 2);
			}
			if (c == 't') {
				bufLen = sprintf(buf, "%smotor disable\r\n", vt100_lineX[12]);
				serial_write_str(&debug, buf, bufLen);
				_dataRpdo[0] = 0x7;
				_dataRpdo[1] = 0;
				Ingenia_write_rpdo(tilt.servo, COB_RPDO1, _dataRpdo, 2);
			}
			else if (c == 's') {
				memset(_dataRpdo, 0, 8);
				v.u32 = 0x500;
				p.i32 = 4000;
				for ( int i = 0; i < 4; i++ ) {
					_dataRpdo[i] = v.b[i];
					_dataRpdo[i + 4] = p.b[i];
				}
				Ingenia_write_rpdo(tilt.servo, COB_RPDO2, _dataRpdo, 8);
				bufLen = sprintf(buf, "%sSet new V:0x500 P:4000c", vt100_lineX[12]);
				serial_write_str(&debug, buf, bufLen);
			}
			else if (c == '>') {
				p.i32 = tilt.servo->posActual + 4000;
				Ingenia_setTargetPositionVelocity(tilt.servo, p.i32, 0x500, 1, 0, 0);
				bufLen = sprintf(buf, "%sto %dc w/ 500c/s", vt100_lineX[12], p.i32);
				serial_write_str(&debug, buf, bufLen);
			}
			else if (c == '<') {
				p.i32 = tilt.servo->posActual - 4000;
				Ingenia_setTargetPositionVelocity(tilt.servo, p.i32, 0x500, 1, 0, 0);
				bufLen = sprintf(buf, "%sto %dc w/ 500c/s", vt100_lineX[12], p.i32);
				serial_write_str(&debug, buf, bufLen);
			}
			else if (c == '0') {
				Ingenia_setTargetPositionVelocity(tilt.servo, 0, 0, 1, 0, 1);
				bufLen = sprintf(buf, "%sMotor Stop!", vt100_lineX[12], p.i32);
				serial_write_str(&debug, buf, bufLen);
			}

		}
#endif	//if DEBUG_MTR_POSVELO==1

		/* TODO END LOOP*/
	}	//while(1){
	/* USER CODE END 3 */
}

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
/* USER CODE BEGIN 4 */
/* TODO Begin of Functions Declaration*/
#if DEBUG==1
void USART6_IRQHandler(void)
{
	USARTx_IRQHandler(&debug);
}
#endif	//if DEBUG==1

void EXTI1_IRQHandler(void)
{
	/* limit azimuth zero active */
	SET_BIT(limitSwitch, (1 << LIM_SWITCH_AZIMUTH_ZERO));
}

void EXTI2_IRQHandler(void)
{
	/* limit elevation UP active */
	SET_BIT(limitSwitch, (1 << LIM_SWITCH_ELEVATION_UP));

	/* check elevation's direction */
	/* stop when direction is UP */
}

void EXTI3_IRQHandler(void)
{
	/* limit elevation DOWN active */
	SET_BIT(limitSwitch, (1 << LIM_SWITCH_ELEVATION_DOWN));

	/* check elevation's direction */
	/* stop when direction is UP */
}

static void initMovementState()
{
	manualCommand[0] = manualCommand[1] = 0;
	stabCommand[0] = stabCommand[1] = 0;
	trackCommand[0] = trackCommand[1] = 0;

	if (moveState == MOVEMENT_STABILIZE) {
		panCommand = &stabCommand[0];
		tiltCommand = &stabCommand[1];
	}
	else if (moveState == MOVEMENT_TRACKING) {
		panCommand = &trackCommand[0];
		tiltCommand = &trackCommand[1];
	}
	else {
		panCommand = &manualCommand[0];
		tiltCommand = &manualCommand[1];
	}
}

static void busExpirationHandler()
{
	static uint32_t buttonCommandTimeout = 0;
	static uint32_t movementModeTimeout = 0;
	uint8_t mStateTemp;

	/* check TRIGGER command */
	if (HAL_GetTick() >= buttonCommandTimeout) {
		HAL_GPIO_WritePin(TRIGGER_ENABLE_GPIO_Port, TRIGGER_ENABLE_Pin, GPIO_PIN_RESET);
		canRecvButton.online = false;
	}

	if (canRecvButton.state) {
		canRecvButton.state = false;
		buttonCommandTimeout = HAL_GetTick() + COMMAND_RECEIVE_TIMEOUT;
		canRecvButton.online = true;

		HAL_GPIO_WritePin(TRIGGER_ENABLE_GPIO_Port, TRIGGER_ENABLE_Pin,
				bitRead(canRecvButton.data[0], 0));

		cockStart = bitRead(canRecvButton.data[0], 1);
	}

	/* check stab command */
	if (HAL_GetTick() >= movementModeTimeout && canRecvPanel.online) {
		canRecvPanel.online = false;
	}

	if (canRecvPanel.state) {
		canRecvPanel.state = false;
		if (moveState == MOVEMENT_MANUAL) {
			movementModeTimeout = HAL_GetTick() + COMMAND_RECEIVE_TIMEOUT;
			canRecvPanel.online = true;

			manualCommandParsing();
		}
		else
			manualCommand[0] = manualCommand[1] = 0;
	}

	/* check stab command */
	if (HAL_GetTick() >= movementModeTimeout && canRecvStabCommand.online) {
		canRecvStabCommand.online = false;
	}

	if (canRecvStabCommand.state) {
		canRecvStabCommand.state = false;
		if (moveState == MOVEMENT_STABILIZE) {
			movementModeTimeout = HAL_GetTick() + COMMAND_RECEIVE_TIMEOUT;
			canRecvStabCommand.online = true;

			stabCommandParsing();
		}
		else
			stabCommand[0] = stabCommand[1] = 0;
	}

	/* check track command */
	if (HAL_GetTick() >= movementModeTimeout && canRecvTrackCommand.online) {
		canRecvTrackCommand.online = false;
	}

	if (canRecvTrackCommand.state) {
		canRecvTrackCommand.state = false;
		if (moveState == MOVEMENT_TRACKING) {
			movementModeTimeout = HAL_GetTick() + COMMAND_RECEIVE_TIMEOUT;
			canRecvTrackCommand.online = true;

			trackCommandParsing();
		}
		else
			trackCommand[0] = trackCommand[1] = 0;
	}

	if (canRecvMoveMode.online) {
		/* check movement mode command (from panel) */
		if (HAL_GetTick() >= movementModeTimeout) {
			HAL_GPIO_WritePin(LED_BUILTIN_GPIO_Port, LED_BUILTIN_Pin, GPIO_PIN_RESET);
			canRecvMoveMode.online = false;
		}

		/* check motor enable command */
		pan.enable = tilt.enable = bitRead(canRecvMoveMode.data[0], 7);

		if (moveState == MOVEMENT_STABILIZE) {
			if (!canRecvStabCommand.online)
				pan.enable = tilt.enable = false;
		}
		else if (moveState == MOVEMENT_TRACKING) {
			if (!canRecvTrackCommand.online)
				pan.enable = tilt.enable = false;
		}
	}
	else {
		pan.enable = false;
		tilt.enable = false;
	}

	if (canRecvMoveMode.state) {
		canRecvMoveMode.state = false;
		movementModeTimeout = HAL_GetTick() + COMMAND_RECEIVE_TIMEOUT;
		canRecvMoveMode.online = true;

		if (bitRead(canRecvMoveMode.data[0], MOVE_TRACK_bit))
			mStateTemp = MOVEMENT_TRACKING;
		else if (bitRead(canRecvMoveMode.data[0], MOVE_STAB_bit))
			mStateTemp = MOVEMENT_STABILIZE;
		else
			mStateTemp = MOVEMENT_MANUAL;

		if (moveState != mStateTemp) {
			moveState = mStateTemp;
			initMovementState();
		}

		HAL_GPIO_TogglePin(LED_BUILTIN_GPIO_Port, LED_BUILTIN_Pin);
	}

}

static void busSendingHandler()
{
	static uint32_t _stateTimer = 1000;
	static uint32_t _angleTimer = 1000;
	static uint32_t _angularSpeedTimer = 1000;
	static uint32_t sumAngleVeloTimer = 0;

	if (HAL_GetTick() >= sumAngleVeloTimer) {
		sumAngleVeloTimer = HAL_GetTick() + 1000;

		canSendMotor.data[2] = crCounter.angleVelo[0] & 0xFF;
		canSendMotor.data[3] = (crCounter.angleVelo[0] >> 8) & 0xFF;
		canSendMotor.data[4] = crCounter.angleVelo[1] & 0xFF;
		canSendMotor.data[5] = (crCounter.angleVelo[1] >> 8) & 0xFF;

		bufLen = sprintf(buf, "%sMval=%d\t\tM(p:t)=%d:%d", vt100_lineX[14],
				(int) crCounter.manualCommand, (int) manualCommand[0], (int) manualCommand[1]);
		serial_write_str(&debug, buf, bufLen);

		bufLen = sprintf(buf, "%sSmode:Sval=%d:%d\tS(p:t)=%d:%d", vt100_lineX[15],
				(int) crCounter.stabMode, (int) crCounter.stabCommand, (int) stabCommand[0],
				(int) stabCommand[1]);
		serial_write_str(&debug, buf, bufLen);

		bufLen = sprintf(buf, "%sTval=%d\tT(p:t)=%d:%d", vt100_lineX[16],
				(int) crCounter.trackCommand, (int) trackCommand[0], (int) trackCommand[1]);
		serial_write_str(&debug, buf, bufLen);

		crCounter.angleVelo[0] = crCounter.angleVelo[1] = 0;
		crCounter.stabMode = crCounter.stabCommand = 0;
	}

	if (HAL_GetTick() >= _stateTimer) {
		_stateTimer = HAL_GetTick() + 100;

		bitWrite(canSendMotor.data[1], 0,
				HAL_GPIO_ReadPin(TRIGGER_ENABLE_GPIO_Port, TRIGGER_ENABLE_Pin));
		bitWrite(canSendMotor.data[1], 1, cockStart);

		busTxHeader->StdId = canSendMotor.id;
		memcpy(busTxBuffer, canSendMotor.data, canSendMotor.size);
		busTxHeader->DLC = canSendMotor.size;
		if (HAL_CAN_AddTxMessage(&hcan2, busTxHeader, busTxBuffer, busTxMailBox) != HAL_OK)
			_stateTimer = HAL_GetTick() + 10;

#if DEBUG==1
		Union_u u, w;

		u.f = C_TO_DEG_AZ(pan.servo->posActual);
		w.f = C_TO_DEG_AZ(pan.servo->veloActual);
		bufLen = sprintf(buf, "%sPAN: P= %d > %.3f\tV= %d > %.3f", vt100_lineX[9],
				(int) pan.servo->posActual, u.f, (int) pan.servo->veloActual, w.f);
		serial_write_str(&debug, buf, bufLen);

		u.f = C_TO_DEG_EL(tilt.servo->posActual);
		w.f = C_TO_DEG_EL(tilt.servo->veloActual);
		bufLen = sprintf(buf, "%sTILT: P= %d > %.3f\tV= %d > %.3f", vt100_lineX[10],
				(int) tilt.servo->posActual, u.f, (int) tilt.servo->veloActual, w.f);
		serial_write_str(&debug, buf, bufLen);
#endif	//if DEBUG==1

	}

	if (HAL_GetTick() >= _angleTimer) {
		_angleTimer = HAL_GetTick() + TPDO4_EVENT_TIMER_100HZ;

		Union_u pAz, pEl;
#if MTR_AZ_ENABLE==1
		pAz.f = pan.relPosition;
#else
		pAz.f = 0.0f;
#endif	//if MTR_AZ_ENABLE==1

#if MTR_EL_ENABLE==1
		pEl.f = tilt.relPosition;
#else
		pEl.f = 0.0f;
#endif	//if MTR_EL_ENABLE==1

		for ( int i = 0; i < 4; i++ ) {
			canSendMotorAngle.data[i] = pAz.b[i];
			canSendMotorAngle.data[i + 4] = pEl.b[i];
		}

		busTxHeader->StdId = canSendMotorAngle.id;
		memcpy(busTxBuffer, canSendMotorAngle.data, canSendMotorAngle.size);
		busTxHeader->DLC = canSendMotorAngle.size;
		if (HAL_CAN_AddTxMessage(&hcan2, busTxHeader, busTxBuffer, busTxMailBox) != HAL_OK)
			_angleTimer = HAL_GetTick() + 1;
	}

	if (HAL_GetTick() >= _angularSpeedTimer) {
		_angularSpeedTimer = HAL_GetTick() + TPDO4_EVENT_TIMER_100HZ;

		Union_u vAz, vEl;
#if MTR_AZ_ENABLE==1
		vAz.f = pan.velo;
#else
		vAz.f = 0.0f;
#endif	//if MTR_AZ_ENABLE==1

#if MTR_EL_ENABLE==1
		vEl.f = tilt.velo;
#else
		vEl.f = 0.0f;
#endif	//if MTR_EL_ENABLE==1

		for ( int i = 0; i < 4; i++ ) {
			canSendMotorSpeed.data[i] = vAz.b[i];
			canSendMotorSpeed.data[i + 4] = vEl.b[i];
		}

		busTxHeader->StdId = canSendMotorSpeed.id;
		memcpy(busTxBuffer, canSendMotorSpeed.data, canSendMotorSpeed.size);
		busTxHeader->DLC = canSendMotorSpeed.size;
		if (HAL_CAN_AddTxMessage(&hcan2, busTxHeader, busTxBuffer, busTxMailBox) != HAL_OK)
			_angleTimer = HAL_GetTick() + 1;
	}
}

static void trackCommandParsing()
{
	Union_u p, t;
	uint8_t dataPT[8];

	memcpy(dataPT, canRecvTrackCommand.data, canRecvTrackCommand.size);

	/* find angular velocity request from stabilize module */
	for ( int i = 0; i < 4; i++ ) {
		p.b[i] = dataPT[i];
		t.b[i] = dataPT[i + 4];
	}

	/* convert from deg/s to c/s */
	trackCommand[0] = (int32_t) DEG_TO_C_AZ(p.f);
	if (abs(trackCommand[0]) > MOTOR_MAX_SPEED) {
		if (trackCommand[0] >= 0)
			trackCommand[0] = MOTOR_MAX_SPEED;
		else
			trackCommand[0] = 0 - MOTOR_MAX_SPEED;
	}
	trackCommand[1] = (int32_t) DEG_TO_C_EL(t.f);
	if (abs(trackCommand[1]) > MOTOR_MAX_SPEED) {
		if (trackCommand[1] >= 0)
			trackCommand[1] = MOTOR_MAX_SPEED;
		else
			trackCommand[1] = 0 - MOTOR_MAX_SPEED;
	}
}

static void stabCommandParsing()
{
	Union_u p, t;
	uint8_t dataPT[8];

	memcpy(dataPT, canRecvStabCommand.data, canRecvStabCommand.size);

	/* find angular velocity request from stabilize module */
	for ( int i = 0; i < 4; i++ ) {
		p.b[i] = dataPT[i];
		t.b[i] = dataPT[i + 4];
	}

	/* convert from deg/s to c/s */
	stabCommand[0] = (int32_t) DEG_TO_C_AZ(p.f);
	if (abs(stabCommand[0]) > MOTOR_MAX_SPEED) {
		if (stabCommand[0] >= 0)
			stabCommand[0] = MOTOR_MAX_SPEED;
		else
			stabCommand[0] = 0 - MOTOR_MAX_SPEED;
	}
	stabCommand[1] = (int32_t) DEG_TO_C_EL(t.f);
	if (abs(stabCommand[1]) > MOTOR_MAX_SPEED) {
		if (stabCommand[1] >= 0)
			stabCommand[1] = MOTOR_MAX_SPEED;
		else
			stabCommand[1] = 0 - MOTOR_MAX_SPEED;
	}
}

static void manualCommandParsing()
{
	Union_u p, t;
	uint8_t dataPT[8];

	memcpy(dataPT, canRecvPanel.data, canRecvPanel.size);

	/* find angular velocity request from stabilize module */
	for ( int i = 0; i < 4; i++ ) {
		p.b[i] = dataPT[i];
		t.b[i] = dataPT[i + 4];
	}

	/* convert from deg/s to c/s */
	manualCommand[0] = (int32_t) DEG_TO_C_AZ(p.f);
	if (abs(manualCommand[0]) > MOTOR_MAX_SPEED) {
		if (manualCommand[0] >= 0)
			manualCommand[0] = MOTOR_MAX_SPEED;
		else
			manualCommand[0] = 0 - MOTOR_MAX_SPEED;
	}
	manualCommand[1] = (int32_t) DEG_TO_C_EL(t.f);
	if (abs(manualCommand[1]) > MOTOR_MAX_SPEED) {
		if (manualCommand[1] >= 0)
			manualCommand[1] = MOTOR_MAX_SPEED;
		else
			manualCommand[1] = 0 - MOTOR_MAX_SPEED;
	}
}

static void motorStop(TServoState *motor)
{
	Ingenia_setTargetPositionVelocity(motor->servo, 0, 0, 1, 0, 1);
}

static void motorSpeed(TServoState *motor, int32_t spd)
{
	int _pos = motor->servo->posActual;
	uint32_t _absSpd = abs(spd);

	if (spd == 0)
		motorStop(motor);
	else {
		if (spd < 0)
			_pos -= 50000;
		else
			_pos += 50000;

		Ingenia_setTargetPositionVelocity(motor->servo, _pos, _absSpd, 1, 0, 0);
	}

	motor->prevSpeed = spd;
}

static void motorHandler()
{
	static uint32_t motorUpdateTimer = 0;
	static uint8_t motorUpdateCounter = 0;

	/* ENABLE/DISABLE MOTOR */
#if MTR_AZ_ENABLE==1
	static _Bool panEnable = 1;

	if (panEnable != pan.enable) {
		if (pan.enable) {
			/* enable motor */
			Ingenia_enableMotor(pan.servo);
		}
		else {
			/* disable motor */
			Ingenia_disableMotor(pan.servo);
		}
		panEnable = pan.enable;
		bitWrite(canSendMotor.data[0], 0, panEnable);
	}
#endif	//if MTR_AZ_ENABLE==1

#if MTR_EL_ENABLE==1
	static _Bool tiltEnable = 1;

	if (tiltEnable != tilt.enable) {
		if (tilt.enable) {
			/* enable motor */
			Ingenia_enableMotor(tilt.servo);
		}
		else {
			/* disable motor */
			Ingenia_disableMotor(tilt.servo);
		}
		tiltEnable = tilt.enable;
		bitWrite(canSendMotor.data[0], 1, tiltEnable);
	}
#endif	//if MTR_EL_ENABLE==1

	/* send command to motor driver */

	if (HAL_GetTick() >= motorUpdateTimer) {
		motorUpdateTimer = HAL_GetTick() + (MOTOR_UPDATE_TIMEOUT / 2);

#if MTR_AZ_ENABLE==1
		if (panEnable && !bitRead(motorUpdateCounter, 0))
			motorSpeed(&pan, *panCommand);
#endif	//if MTR_AZ_ENABLE==1

#if MTR_EL_ENABLE==1
		if (tiltEnable && bitRead(motorUpdateCounter, 0))
			motorSpeed(&tilt, *tiltCommand);
#endif	//if MTR_EL_ENABLE==1

		motorUpdateCounter++;
	}
}

static void motorParamInit(Servo_t *servo)
{

	Ingenia_write_nmt(servo, NMT_START_REMOTE_NODE);

	/* set mode to profile position */
	Ingenia_setModeOfOperation(servo, DRIVE_MODE_PROFILE_POSITION);

	/* set max motor speed */
	Ingenia_write_sdo_u32(servo, 0x6080, 0, MOTOR_MAX_SPEED);
	/* set max velocity profile */
	Ingenia_write_sdo_u32(servo, 0x607F, 0, MOTOR_MAX_SPEED);
	/* set max profile acceleration */
	Ingenia_write_sdo_u32(servo, 0x6083, 0, MOTOR_MAX_ACCEL);
	/* set max profile de-acceleration */
	Ingenia_write_sdo_u32(servo, 0x6084, 0, MOTOR_MAX_ACCEL);
	/* set max profile quick stop de-acceleration */
	Ingenia_write_sdo_u32(servo, 0x6085, 0, 2 * MOTOR_MAX_ACCEL);
	/* set TPDO4 event timer */
	Ingenia_write_sdo_u16(servo, 0x1803, 5, TPDO4_EVENT_TIMER_100HZ);
}

static HAL_StatusTypeDef motorInit()
{
	HAL_StatusTypeDef ret = HAL_OK;
	Ingenia_begin(&hcan1);

#if DEBUG_INGENIA_DRIVER==1
	Ingenia_init(&mtr, 0x21);
	Ingenia_init(&dummy, 0x22);
	Ingenia_node_remove(&dummy);

	debugMotor();
#endif	//if DEBUG_INGENIA_DRIVER==1

#if MTR_AZ_ENABLE==1
	pan.name = SERVO_PAN;
	pan.enable = false;
	pan.direction = DIR_UP_RIGHT;
	pan.servo = &mtrAzi;
	pan.prevSpeed = 1;

	if (Ingenia_init(pan.servo, MTR_AZ_ID) != HAL_OK)
		return HAL_ERROR;

#if DEBUG==1
	bufLen = sprintf(buf, "enabling pan motor...");
	serial_write_str(&debug, buf, bufLen);
#endif	//if DEBUG==1

	motorParamInit(pan.servo);
	Ingenia_disableMotor(pan.servo);

#if DEBUG==1
	bufLen = sprintf(buf, "done!\r\n");
	serial_write_str(&debug, buf, bufLen);
#endif	//if DEBUG==1

#endif	//if MTR_AZ_ENABLE==1

#if MTR_EL_ENABLE==1
	tilt.name = SERVO_TILT;
	tilt.enable = false;
	tilt.direction = DIR_UP_RIGHT;
	tilt.servo = &mtrEle;
	tilt.prevSpeed = 1;

	if (Ingenia_init(tilt.servo, MTR_EL_ID) != HAL_OK)
		return HAL_ERROR;

#if DEBUG==1
	bufLen = sprintf(buf, "enabling tilt motor...");
	serial_write_str(&debug, buf, bufLen);
#endif	//if DEBUG==1

	motorParamInit(tilt.servo);
	Ingenia_disableMotor(tilt.servo);

#if DEBUG==1
	bufLen = sprintf(buf, "done!\r\n");
	serial_write_str(&debug, buf, bufLen);
#endif	//if DEBUG==1
#endif	//if MTR_EL_ENABLE==1

#if MTR_COCK_ENABLE==1
	Ingenia_init(cock.servo, MTR_COCK_ID);
#endif	//if MTR_COCK_ENABLE==1

	return ret;
}

static HAL_StatusTypeDef busInit()
{
	busTxHeader = &can2TxHeader;
	busTxMailBox = &can2TxMailBox;
	busTxBuffer = can2TxBuffer;
	busRxHeader = &can2RxHeader;
	busRxBuffer = can2RxBuffer;

	CAN_FilterTypeDef sFilterConfig;

	/*##-2- Configure the CAN Filter ###########################################*/

	sFilterConfig.FilterBank = 14;
	sFilterConfig.FilterMode = CAN_FILTERMODE_IDMASK;
	sFilterConfig.FilterScale = CAN_FILTERSCALE_32BIT;
	sFilterConfig.FilterIdHigh = (canRecvPanel.id << 5);
	sFilterConfig.FilterIdLow = 0;
	sFilterConfig.FilterMaskIdHigh = (canRecvPanel.id << 5);
	sFilterConfig.FilterMaskIdLow = 0;
	sFilterConfig.FilterFIFOAssignment = CAN_RX_FIFO1;
	sFilterConfig.FilterActivation = ENABLE;
	sFilterConfig.SlaveStartFilterBank = 14;

	if (HAL_CAN_ConfigFilter(&hcan2, &sFilterConfig) != HAL_OK) {
		/* filter configuration error */
		return HAL_ERROR;
	}

	sFilterConfig.FilterBank = 15;
	sFilterConfig.FilterMode = CAN_FILTERMODE_IDMASK;
	sFilterConfig.FilterScale = CAN_FILTERSCALE_32BIT;
	sFilterConfig.FilterIdHigh = (canRecvButton.id << 5);
	sFilterConfig.FilterIdLow = 0;
	sFilterConfig.FilterMaskIdHigh = (canRecvButton.id << 5);
	sFilterConfig.FilterMaskIdLow = 0;
	sFilterConfig.FilterFIFOAssignment = CAN_RX_FIFO1;
	sFilterConfig.FilterActivation = ENABLE;
	sFilterConfig.SlaveStartFilterBank = 14;

	if (HAL_CAN_ConfigFilter(&hcan2, &sFilterConfig) != HAL_OK) {
		/* filter configuration error */
		return HAL_ERROR;
	}

	sFilterConfig.FilterBank = 16;
	sFilterConfig.FilterMode = CAN_FILTERMODE_IDMASK;
	sFilterConfig.FilterScale = CAN_FILTERSCALE_32BIT;
	sFilterConfig.FilterIdHigh = (canRecvMoveMode.id << 5);
	sFilterConfig.FilterIdLow = 0;
	sFilterConfig.FilterMaskIdHigh = (canRecvMoveMode.id << 5);
	sFilterConfig.FilterMaskIdLow = 0;
	sFilterConfig.FilterFIFOAssignment = CAN_RX_FIFO1;
	sFilterConfig.FilterActivation = ENABLE;
	sFilterConfig.SlaveStartFilterBank = 14;

	if (HAL_CAN_ConfigFilter(&hcan2, &sFilterConfig) != HAL_OK) {
		/* filter configuration error */
		return HAL_ERROR;
	}

	sFilterConfig.FilterBank = 17;
	sFilterConfig.FilterMode = CAN_FILTERMODE_IDMASK;
	sFilterConfig.FilterScale = CAN_FILTERSCALE_32BIT;
	sFilterConfig.FilterIdHigh = (canRecvStabCommand.id << 5);
	sFilterConfig.FilterIdLow = 0;
	sFilterConfig.FilterMaskIdHigh = (canRecvStabCommand.id << 5);
	sFilterConfig.FilterMaskIdLow = 0;
	sFilterConfig.FilterFIFOAssignment = CAN_RX_FIFO1;
	sFilterConfig.FilterActivation = ENABLE;
	sFilterConfig.SlaveStartFilterBank = 14;

	if (HAL_CAN_ConfigFilter(&hcan2, &sFilterConfig) != HAL_OK) {
		/* filter configuration error */
		return HAL_ERROR;
	}

	sFilterConfig.FilterBank = 18;
	sFilterConfig.FilterMode = CAN_FILTERMODE_IDMASK;
	sFilterConfig.FilterScale = CAN_FILTERSCALE_32BIT;
	sFilterConfig.FilterIdHigh = (canRecvTrackCommand.id << 5);
	sFilterConfig.FilterIdLow = 0;
	sFilterConfig.FilterMaskIdHigh = (canRecvTrackCommand.id << 5);
	sFilterConfig.FilterMaskIdLow = 0;
	sFilterConfig.FilterFIFOAssignment = CAN_RX_FIFO1;
	sFilterConfig.FilterActivation = ENABLE;
	sFilterConfig.SlaveStartFilterBank = 14;

	if (HAL_CAN_ConfigFilter(&hcan2, &sFilterConfig) != HAL_OK) {
		/* filter configuration error */
		return HAL_ERROR;
	}

	/*##-3- Start the CAN peripheral ###########################################*/
	if (HAL_CAN_Start(&hcan2) != HAL_OK) {
		/* Start Error */
		return HAL_ERROR;
	}

	/*##-4- Activate CAN RX notification #######################################*/
	if (HAL_CAN_ActivateNotification(&hcan2, CAN_IT_RX_FIFO1_MSG_PENDING) != HAL_OK) {
		/* Notification Error */
		return HAL_ERROR;
	}

	/*##-5- Configure Transmission process #####################################*/
	busTxHeader->StdId = 0x1;
	busTxHeader->RTR = CAN_RTR_DATA;
	busTxHeader->IDE = CAN_ID_STD;
	busTxHeader->DLC = CAN_DATA_MAX;
	busTxHeader->TransmitGlobalTime = DISABLE;

	return HAL_OK;
}

static void busHandler(CAN_HandleTypeDef *bus)
{
	uint32_t _id = 0;

	if (HAL_CAN_GetRxMessage(bus, CAN_RX_FIFO1, busRxHeader, busRxBuffer) == HAL_OK) {
		_id = busRxHeader->StdId;
		if (_id == canRecvPanel.id) {
			canRecvPanel.state = true;
			memcpy(canRecvPanel.data, busRxBuffer, canRecvPanel.size);
			crCounter.manualCommand++;
		}
		else if (_id == canRecvButton.id) {
			canRecvButton.state = true;
			memcpy(canRecvButton.data, busRxBuffer, canRecvButton.size);
		}
		else if (_id == canRecvMoveMode.id) {
			canRecvMoveMode.state = true;
			memcpy(canRecvMoveMode.data, busRxBuffer, canRecvMoveMode.size);
			crCounter.stabMode++;
		}
		else if (_id == canRecvStabCommand.id) {
			canRecvStabCommand.state = true;
			memcpy(canRecvStabCommand.data, busRxBuffer, canRecvStabCommand.size);
			crCounter.stabCommand++;
		}
		else if (_id == canRecvTrackCommand.id) {
			canRecvTrackCommand.state = true;
			memcpy(canRecvTrackCommand.data, busRxBuffer, canRecvTrackCommand.size);
			crCounter.trackCommand++;
		}
	}
}

/**
 * @brief  Rx Fifo 1 message pending callback
 * @param  hcan: pointer to a CAN_HandleTypeDef structure that contains
 *         the configuration information for the specified CAN.
 * @retval None
 */
void HAL_CAN_RxFifo1MsgPendingCallback(CAN_HandleTypeDef *hcan)
{
	busHandler(hcan);
}

void Ingenia_tpdo_callback(CAN_Buffer_t *buffer)
{
	CAN_Data_t data;
	uint32_t idNode = 0;
	int _pos = 0, _velo = 0;

	if (can_buffer_available(buffer)) {
		can_buffer_read(buffer, &data);
#if DEBUG_MTR_POSVELO==1
		countTPDO4++;
#endif	//if DEBUG_MTR_POSVELO==1

		if ((data.canRxHeader.StdId & COB_TPDO4) == COB_TPDO4) {
			idNode = data.canRxHeader.StdId - COB_TPDO4;
			for ( int i = 0; i < 4; i++ ) {
				_pos |= (int) data.rxData[i] << (8 * i);
				_velo |= (int) data.rxData[i + 4] << (8 * i);
			}
#if MTR_AZ_ENABLE==1
			if (idNode == mtrAzi._u8Node) {
				pan.servo->posActual = _pos;
				pan.servo->veloActual = _velo;

				int32_t _tem = abs(_pos) % C_AZ_FULLSWING;
				if (_pos < 0)
					_tem = C_AZ_FULLSWING - _tem;
				pan.relPosition = C_TO_DEG_AZ(_tem);
				pan.velo = C_TO_DEG_AZ(_velo);

				crCounter.angleVelo[0]++;
			}
#endif	//if MTR_AZ_ENABLE==1

#if MTR_EL_ENABLE==1
			if (idNode == mtrEle._u8Node) {
				tilt.servo->posActual = _pos;
				tilt.servo->veloActual = _velo;

				tilt.relPosition = C_TO_DEG_EL(_pos);
				tilt.velo = C_TO_DEG_EL(_velo);

				crCounter.angleVelo[1]++;
			}
#endif	//if MTR_EL_ENABLE==1

		}
	}
}

/* USER CODE END 4 */
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
