kurrosetra/RCWS-FA/Button/Firmwares/Button/Button.ioc

Mcu.UserName=STM32F103C8Tx
PA0-WKUP.GPIO_Label=TRK_ON
PA0-WKUP.Signal=GPIO_Input
PA1.GPIO_Label=FIRE_ACTIVE
PA1.Signal=GPIO_Input
PA10.GPIO_Label=PANEL_TXD
PA10.Signal=USART1_RX
PA11.Signal=CAN_RX
PA12.Signal=CAN_TX
PA13.Signal=SYS_JTMS-SWDIO
PA14.Signal=SYS_JTCK-SWCLK
PA15.GPIO_Label=CAM_ZOOM_OUT
PA15.Signal=GPIO_Input
PA2.GPIO_Label=TRK_PREV
PA2.Signal=GPIO_Input
PA3.GPIO_Label=CAM_FOCUS_NEAR
PA3.Signal=GPIO_Input
PA4.GPIO_Label=CAM_SEL_THERMAL
PA4.Signal=GPIO_Input
PA5.GPIO_Label=JSL_ELEVATION
PA5.Signal=ADCx_IN5
PA6.GPIO_Label=JSL_AZIMUTH
PA6.Signal=ADCx_IN6
PA7.GPIO_Label=JSR_DEADMAN
PA7.Signal=GPIO_Input
PA8.GPIO_Label=JSL_TRIG
PA8.Signal=GPIO_Input
PA9.GPIO_Label=PANEL_RXD
PA9.Signal=USART1_TX
PB0.GPIO_Label=JSR_AZIMUTH
PB0.Signal=ADCx_IN8
PB1.GPIO_Label=JSR_ELEVATION
PB1.Signal=ADCx_IN9
PB10.GPIO_Label=JSR_B
PB10.Signal=GPIO_Input
PB11.GPIO_Label=JSR_TRIG
PB11.Signal=GPIO_Input
PB12.GPIO_Label=LED
PB12.Signal=GPIO_Output
PB13.GPIO_Label=JSL_DEADMAN
PB13.Signal=GPIO_Input
PB14.GPIO_Label=JSL_A
PB14.Signal=GPIO_Input
PB15.GPIO_Label=JSL_B
PB15.Signal=GPIO_Input
PB2.GPIO_Label=JSR_A
PB2.Signal=GPIO_Input
PB3.GPIO_Label=LRF_MAN_DOWN
PB3.Signal=GPIO_Input
PB4.GPIO_Label=LRF_START
PB4.Signal=GPIO_Input
PB5.GPIO_Label=MTR_SPD_HIGH
PB5.Signal=GPIO_Input
PB6.GPIO_Label=MTR_SPD_LOW
PB6.Signal=GPIO_Input
PB7.GPIO_Label=LRF_EN
PB7.Signal=GPIO_Input
PB8.GPIO_Label=LRF_MAN_UP
PB8.Signal=GPIO_Input
PB9.GPIO_Label=CAM_ZOOM_IN
PB9.Signal=GPIO_Input
PC13-TAMPER-RTC.GPIO_Label=LED1
PC13-TAMPER-RTC.Signal=GPIO_Output
PC14-OSC32_IN.GPIO_Label=LED2
PC14-OSC32_IN.Signal=GPIO_Output
PC15-OSC32_OUT.GPIO_Label=CAM_SEL_DAY
PC15-OSC32_OUT.Signal=GPIO_Input
PD0-OSC_IN.GPIO_Label=CAM_FOCUS_FAR
PD0-OSC_IN.Signal=GPIO_Input
PD1-OSC_OUT.GPIO_Label=TRK_NEXT
PD1-OSC_OUT.Signal=GPIO_Input
