kurrosetra/RCWS-FA/Button/Firmwares/Button/Src/main.c

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
/* Includes ------------------------------------------------------------------*/
#include "main.h"

/* USER CODE BEGIN Includes */
#include <string.h>
#include "stm_hal_serial.h"
/* USER CODE END Includes */

ADC_HandleTypeDef hadc1;
DMA_HandleTypeDef hdma_adc1;

IWDG_HandleTypeDef hiwdg;

TIM_HandleTypeDef htim3;

UART_HandleTypeDef huart1;

/* USER CODE BEGIN PV */
/* TODO Private Variables*/
#define DEBUG					0
#if DEBUG==1
#	define JOYSTICK_DEBUG		0
#	define BUTTON_DEBUG			0
#	define CMD_DEBUG			0
#endif	//if DEBUG==1

#define bitRead(value, bit) (((value) >> (bit)) & 0x01)
#define bitSet(value, bit) ((value) |= (1UL << (bit)))
#define bitClear(value, bit) ((value) &= ~(1UL << (bit)))
#define bitWrite(value, bit, bitvalue) (bitvalue ? bitSet(value, bit) : bitClear(value, bit))

#define UART_BUFSIZE	RING_BUFFER_SIZE

uint16_t bufLen = 0;
char buf[128];

Ring_Buffer_t tx1Buffer = { { 0 }, 0, 0 };
Ring_Buffer_t rx1Buffer = { { 0 }, 0, 0 };
TSerial panel = { &rx1Buffer, &tx1Buffer, &huart1 };
#define CMD_BUFSIZE			32
char cmdIn[CMD_BUFSIZE];

typedef struct
{
	uint8_t id;
	uint8_t dtab;
	volatile uint16_t azimuth;
	volatile uint16_t elevation;
} Joystick_t;
Joystick_t jRight = { 0, 0, 0, 0 };
Joystick_t jLeft = { 1, 0, 0, 0 };

volatile uint16_t adcValArray[4];
uint32_t buttonState = 0;
/* USER CODE END PV */

void SystemClock_Config(void);
static void MX_GPIO_Init(void);
static void MX_DMA_Init(void);
static void MX_USART1_UART_Init(void);
static void MX_ADC1_Init(void);
static void MX_IWDG_Init(void);
static void MX_TIM3_Init(void);
/* USER CODE BEGIN PFP */
/* TODO Private Function Prototypes*/
static void jsHandler();
static void btnHandler();
static void cmdHandler();

/* USER CODE END PFP */

/**
  * @brief  The application entry point.
  * @retval int
  */
int main(void)
{
  /* MCU Configuration--------------------------------------------------------*/

  /* Reset of all peripherals, Initializes the Flash interface and the Systick. */
  HAL_Init();

  /* Configure the system clock */
  SystemClock_Config();

  /* Initialize all configured peripherals */
  MX_GPIO_Init();
  MX_DMA_Init();
  MX_USART1_UART_Init();
  MX_ADC1_Init();
  MX_IWDG_Init();
  MX_TIM3_Init();
  /* USER CODE BEGIN 2 */
	/* TODO Initialization*/
	HAL_IWDG_Init(&hiwdg);
	HAL_IWDG_Refresh(&hiwdg);
#if DEBUG==1
	bufLen = sprintf(buf, "Button - Panel RWS firmware!\r\n");
	serial_write_str(&panel, buf, bufLen);
#endif	//if DEBUG==1

	serial_init(&panel);

	HAL_TIM_Base_Start(&htim3);
	HAL_ADC_Start_DMA(&hadc1, (uint32_t *) adcValArray, 4);

  /* USER CODE END 2 */

  /* Infinite loop */
  /* USER CODE BEGIN WHILE */
	/* TODO Private Variables*/
	uint32_t millis = 0;
	uint32_t ledTimer = 1000;
	while (1) {
		HAL_IWDG_Refresh(&hiwdg);
		millis = HAL_GetTick();
    /* USER CODE END WHILE */

    /* USER CODE BEGIN 3 */
		/* TODO BEGIN LOOP*/
		if (millis >= ledTimer) {
			ledTimer = millis + 50;

#if JOYSTICK_DEBUG==1
			bufLen = sprintf(buf, "jsR:\tdTAB:%d%d%d%d\t%d %d\r\n", bitRead(jRight.dtab, 0),
					bitRead(jRight.dtab, 1), bitRead(jRight.dtab, 2), bitRead(jRight.dtab, 3),
					jRight.azimuth, jRight.elevation);
			serial_write_str(&panel, buf, bufLen);
			bufLen = sprintf(buf, "jsL:\tdTAB:%d%d%d%d\t%d %d\r\n", bitRead(jLeft.dtab, 0),
					bitRead(jLeft.dtab, 1), bitRead(jLeft.dtab, 2), bitRead(jLeft.dtab, 3),
					jLeft.azimuth, jLeft.elevation);
			serial_write_str(&panel, buf, bufLen);
#endif	//if JOYSTICK_DEBUG==1

#if BUTTON_DEBUG==1
			bufLen = sprintf(buf, "buttonState= 0b");
			serial_write_str(&panel, buf, bufLen);
			for ( int i = 0; i < 16; i++ )
			serial_write(&panel, bitRead(buttonState,i) + '0');
			serial_write_str(&panel, "\r\n", 2);
#endif	//if BUTTON_DEBUG==1

#if DEBUG==0
			bufLen = sprintf(buf, "$BTN,%d,%d,%d,%d,%d,%d,%d*\r\n", buttonState, jRight.dtab,
					jRight.azimuth, jRight.elevation, jLeft.dtab, jLeft.azimuth, jLeft.elevation);
			serial_write_str(&panel, buf, bufLen);
#endif	//if DEBUG==0

		}

		jsHandler();
		btnHandler();
		cmdHandler();

		/* TODO END LOOP*/
	}
  /* USER CODE END 3 */
}

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
/* USER CODE BEGIN 4 */
/* TODO Function Declaration*/
static void jsHandler()
{
	bitWrite(jRight.dtab, 0, HAL_GPIO_ReadPin(JSR_DEADMAN_GPIO_Port, JSR_DEADMAN_Pin));
	bitWrite(jRight.dtab, 1, HAL_GPIO_ReadPin(JSR_TRIG_GPIO_Port, JSR_TRIG_Pin));
	bitWrite(jRight.dtab, 2, HAL_GPIO_ReadPin(JSR_A_GPIO_Port,JSR_A_Pin));
	bitWrite(jRight.dtab, 3, HAL_GPIO_ReadPin(JSR_B_GPIO_Port,JSR_B_Pin));

	bitWrite(jLeft.dtab, 0, !HAL_GPIO_ReadPin(JSL_DEADMAN_GPIO_Port, JSL_DEADMAN_Pin));
	bitWrite(jLeft.dtab, 1, !HAL_GPIO_ReadPin(JSL_TRIG_GPIO_Port, JSL_TRIG_Pin));
	bitWrite(jLeft.dtab, 2, !HAL_GPIO_ReadPin(JSL_A_GPIO_Port,JSL_A_Pin));
	bitWrite(jLeft.dtab, 3, !HAL_GPIO_ReadPin(JSL_B_GPIO_Port,JSL_B_Pin));
}

static void btnHandler()
{
	bitWrite(buttonState, 0, !HAL_GPIO_ReadPin(MTR_SPD_LOW_GPIO_Port,MTR_SPD_LOW_Pin));
	bitWrite(buttonState, 1, !HAL_GPIO_ReadPin(MTR_SPD_HIGH_GPIO_Port,MTR_SPD_HIGH_Pin));

	bitWrite(buttonState, 2, !HAL_GPIO_ReadPin(LRF_EN_GPIO_Port,LRF_EN_Pin));
	bitWrite(buttonState, 3, !HAL_GPIO_ReadPin(LRF_START_GPIO_Port,LRF_START_Pin));
	bitWrite(buttonState, 4, !HAL_GPIO_ReadPin(LRF_MAN_UP_GPIO_Port,LRF_MAN_UP_Pin));
	bitWrite(buttonState, 5, !HAL_GPIO_ReadPin(LRF_MAN_DOWN_GPIO_Port,LRF_MAN_DOWN_Pin));

	bitWrite(buttonState, 6, !HAL_GPIO_ReadPin(CAM_ZOOM_IN_GPIO_Port,CAM_ZOOM_IN_Pin));
	bitWrite(buttonState, 7, !HAL_GPIO_ReadPin(CAM_ZOOM_OUT_GPIO_Port,CAM_ZOOM_OUT_Pin));
	bitWrite(buttonState, 8, !HAL_GPIO_ReadPin(CAM_SEL_DAY_GPIO_Port,CAM_SEL_DAY_Pin));
	bitWrite(buttonState, 9, !HAL_GPIO_ReadPin(CAM_SEL_THERMAL_GPIO_Port,CAM_SEL_THERMAL_Pin));
	bitWrite(buttonState, 10, !HAL_GPIO_ReadPin(CAM_FOCUS_FAR_GPIO_Port,CAM_FOCUS_FAR_Pin));
	bitWrite(buttonState, 11, !HAL_GPIO_ReadPin(CAM_FOCUS_NEAR_GPIO_Port,CAM_FOCUS_NEAR_Pin));

	bitWrite(buttonState, 12, !HAL_GPIO_ReadPin(TRK_ON_GPIO_Port,TRK_ON_Pin));
	bitWrite(buttonState, 13, !HAL_GPIO_ReadPin(TRK_NEXT_GPIO_Port,TRK_NEXT_Pin));
	bitWrite(buttonState, 14, !HAL_GPIO_ReadPin(TRK_PREV_GPIO_Port,TRK_PREV_Pin));

	bitWrite(buttonState, 15, !HAL_GPIO_ReadPin(FIRE_ACTIVE_GPIO_Port,FIRE_ACTIVE_Pin));

}

static void cmdHandler()
{
	bool cmdCompleted = false;
	char c;
	uint8_t ledState = 0;

	if (serial_available(&panel)) {
		c = serial_read(&panel);

		if (c == '$')
			memset(cmdIn, 0, CMD_BUFSIZE);
		else if (c == '*')
			cmdCompleted = true;

		strncat(cmdIn, (const char *) &c, 1);
	}

	if (cmdCompleted) {
#if CMD_DEBUG==1
		bufLen = sprintf(buf, "len=%d\t%s\r\n", strlen(cmdIn), cmdIn);
		serial_write_str(&panel, buf, bufLen);
#endif	//if CMD_DEBUG==1

		if (strncmp(cmdIn, "$LED,", 5) == 0 && strlen(cmdIn) == 7) {
			if (cmdIn[5] >= '0' && cmdIn[5] <= '9') {
				ledState = (uint8_t) (cmdIn[5] - '0');

				HAL_GPIO_WritePin(LED1_GPIO_Port, LED1_Pin, bitRead(ledState, 0));
				HAL_GPIO_WritePin(LED2_GPIO_Port, LED2_Pin, bitRead(ledState, 1));
			}
		}
		HAL_GPIO_TogglePin(LED_GPIO_Port, LED_Pin);
	}
}

void USART1_IRQHandler(void)
{
	USARTx_IRQHandler(&panel);
}

void HAL_ADC_ConvCpltCallback(ADC_HandleTypeDef* hadc)
{
	jRight.azimuth = ((jRight.azimuth * 9) + (adcValArray[0] * 1)) / 10;
	jRight.elevation = ((jRight.elevation * 9) + (adcValArray[1] * 1)) / 10;
	jLeft.azimuth = ((jLeft.azimuth * 9) + (adcValArray[2] * 1)) / 10;
	jLeft.elevation = ((jLeft.elevation * 9) + (adcValArray[3] * 1)) / 10;
}

/* USER CODE END 4 */
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
