kurrosetra/RCWS-FA/(commit log)

2018-11-19 v2.0.0
    Firmware's Skeleton for:
    1. MotorControl
    2. Optronik:
    a. OPT_CAM
    b. OPT_MISC
    [Optronik.brd, Optronik.sch, motorControl.brd, motorControl.sch]
2020-07-08 remove motorController
2020-07-08 add new motorController skeleton
2020-07-14 motorController using CAN done
    maximal speed at 1700RPM -> 115000 c/s
2021-02-02 implement stabilized module
    changelog:
    1. add stabilized module
    2. output angle & angular velocity to can bus
    3. change motor command rate to 100Hz
    4. change tracking control function
    [canID.xlsx]
2021-02-04 change data rate to 200Hz
    Changelog:
    1. change CAN bus baud rate to 500kbps
    2. change motor data rate to 200Hz
2021-02-09 add stabilize algorithm to motorController
    - add stab algorithm to motorController
    - stabilized module change to imu module
    - imu module sending 200Hz pitch roll when stab ON
    - imu sending YPR in 10Hz
    - panel sending stab correction speed
    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
    [canID.xlsx]
2021-02-09 Revert "add stabilize algorithm to motorController"
    This reverts commit cf9d517c3015458b58b7940c70b162da2cd40f1b.
    [canID.xlsx]
2021-02-10 change data rate to 100Hz
    - change data rate stabilize to 100Hz
    - data out stab module send directly to motorController
    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
    [main.c]
2021-02-10 add stabControl to motorControl
    - add skeleton (unfinished)
    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
2021-02-10 Revert "add stabControl to motorControl"
    This reverts commit cba918d5b6c0c59a66daf927579500fcb2686614.
    [main.c]
2021-02-10 Revert "change data rate to 100Hz"
    This reverts commit dab9432a420b981d945815ab0da7c72165903b25.
    [main.c]
2021-02-10 Revert "Revert "change data rate to 100Hz""
    This reverts commit 9acc7dfb9b0539415d1886535320aa56c5047b3e.
    [main.c]
2021-02-10 tidy up motorControl
2021-02-10 Revert "DEV-STAB temp"
    This reverts commit a1c3928487bb0004f1b4590b5f40d119d2f211b3.
    [main.c]
2021-02-10 Revert "tidy up motorControl"
    This reverts commit 811e48e1a20db5133546eff21529c18726f3974a.
    [main.c]
2021-02-16 add stacker modul
    - add stabilizer & tracker module
    - put common library (rwsCanID.h, uart & servoDriver) to folder Documents\Library\
    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
2021-02-16 change motor control algorithm-NOT DONE YET!
    [canID.xlsx]
2021-02-16 change motor control algorithm
    ready to debug
2021-02-17 first test of new motor contol algorithm
