kurrosetra/RCWS-FA/(notices)

Notices in the files:
Button/Firmwares/Button/Src/main.c:
© Copyright (c) 2021 STMicroelectronics.
All rights reserved.
This software component is licensed by ST under BSD 3-Clause license,
the "License"; You may not use this file except in compliance with the
License. You may obtain a copy of the License at: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
(C) COPYRIGHT STMicroelectronics *****END OF FILE
MotorControl/Firmwares/motorController/Src/main.c:
© Copyright (c) 2020 STMicroelectronics.
parts and their libraries:
SparkFun: Licensing: CC v3.0 Share-Alike You are welcome to use this library for commercial purposes.
rc-master: Copyright (C) 2007, Bob Starr
SparkFun-DigitalIC: Licensing: Creative Commons ShareAlike 4.0 International - https://creativecommons.org/licenses/by-sa/4.0
